LegendOfOwl/hiz-750-rc-jet/cad/out/HIZ750_inboard.pdf

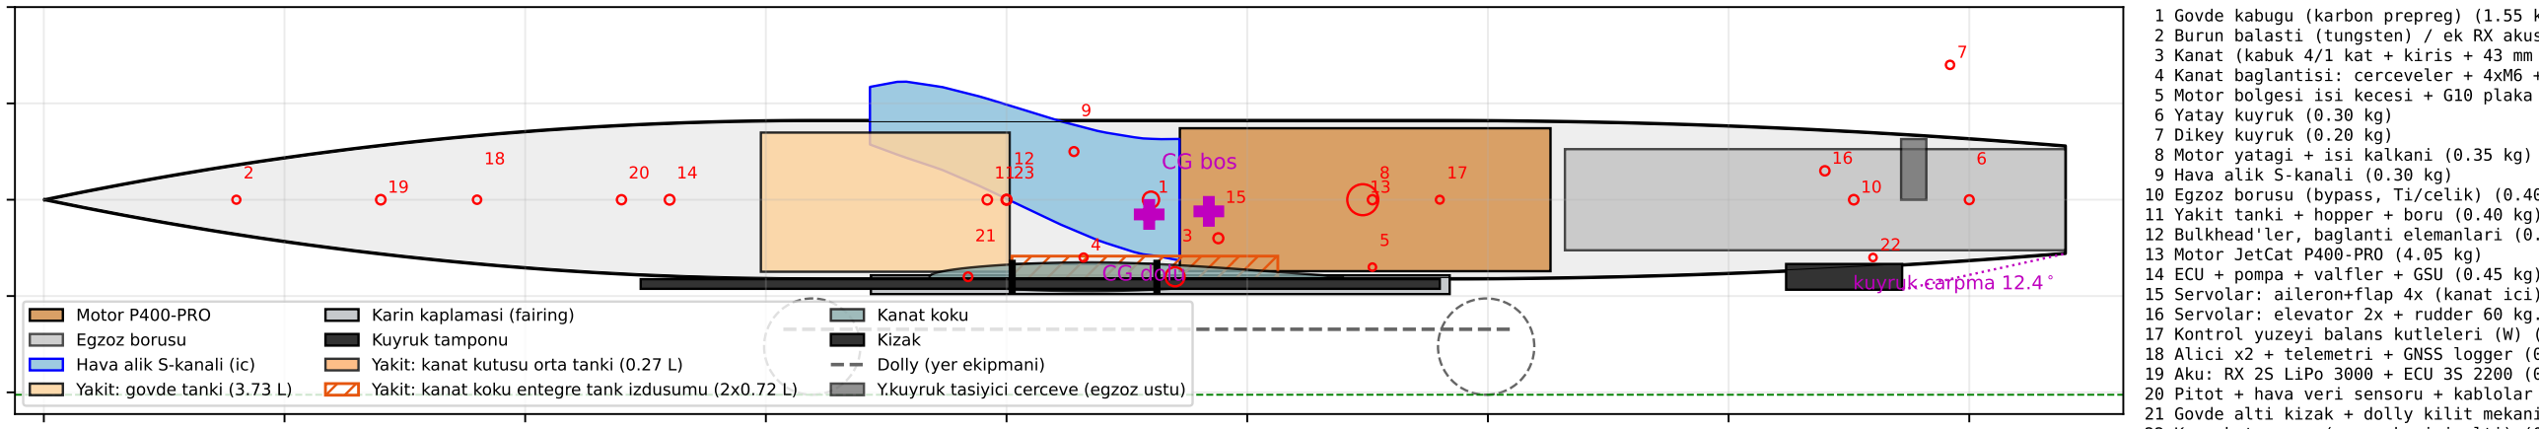
[picture p29: figure]
22 kuyruk carpma 12.4; CG dolu; 6 Yatay kuyruk (0.30 kg) 7 Dikey kuyruk (0.20 kg) 8 Motor yatagi + isi kalkani (0.35 kg) 9 Hava alik S-kanali (0.30 kg); 13 Motor JetCat P400-PRO (4.05 kg)

0 | 250 | 500 | 750 | 1000 | 1250 | 1500 | 1750 | 2000
| | | | x [mm] (burun ucundan)

−200

−100

0

100

200

# z [mm]

2 | 18 19 | 20 14 | 11 | CG bos 12 23 1 15 | 8 17 13 | 16 10 | 6
Motor P400-PRO Egzoz borusu Hava alik S-kanali (ic) Yakit: govde tanki (3.73 L) | Karin kaplamasi (fairing) Kuyruk tamponu Yakit: kanat kutusu orta tanki (0.27 L) Yakit: kanat koku entegre tank izdusumu (2x0.72 L) | | Kanat koku Kizak Dolly (yer ekipmani) Y.kuyruk tasiyici cerceve (egzoz ustu)

1 Govde kabugu (karbon prepreg) (1.55 kg)
2 Burun balasti (tungsten) / ek RX akusu (0.15 kg)
3 Kanat (kabuk 4/1 kat + kiris + 43 mm kaburga) (2.03 kg) 4 Kanat baglantisi: cerceveler + 4xM6 + blok (0.15 kg)
5 Motor bolgesi isi kecesi + G10 plaka (0.05 kg)

10 Egzoz borusu (bypass, Ti/celik) (0.40 kg) 11 Yakit tanki + hopper + boru (0.40 kg)
12 Bulkhead'ler, baglanti elemanlari (0.50 kg)

14 ECU + pompa + valfler + GSU (0.45 kg)
15 Servolar: aileron+flap 4x (kanat ici) (0.48 kg) 16 Servolar: elevator 2x + rudder 60 kg.cm (0.37 kg) 17 Kontrol yuzeyi balans kutleleri (W) (0.12 kg)
18 Alici x2 + telemetri + GNSS logger (0.20 kg)
19 Aku: RX 2S LiPo 3000 + ECU 3S 2200 (0.40 kg)
20 Pitot + hava veri sensoru + kablolar (0.35 kg)
21 Govde alti kizak + dolly kilit mekanizmasi (0.25 kg) 22 Kuyruk tamponu (egzoz konisi alti) (0.04 kg)
23 Boya / dolgu / balans (0.35 kg)

# HIZ-750 ic yerlesim (inboard profile) - merkez duzlem kesiti
