LegendOfOwl/hiz-750-rc-jet/aero/out/ucak_polari_750.png

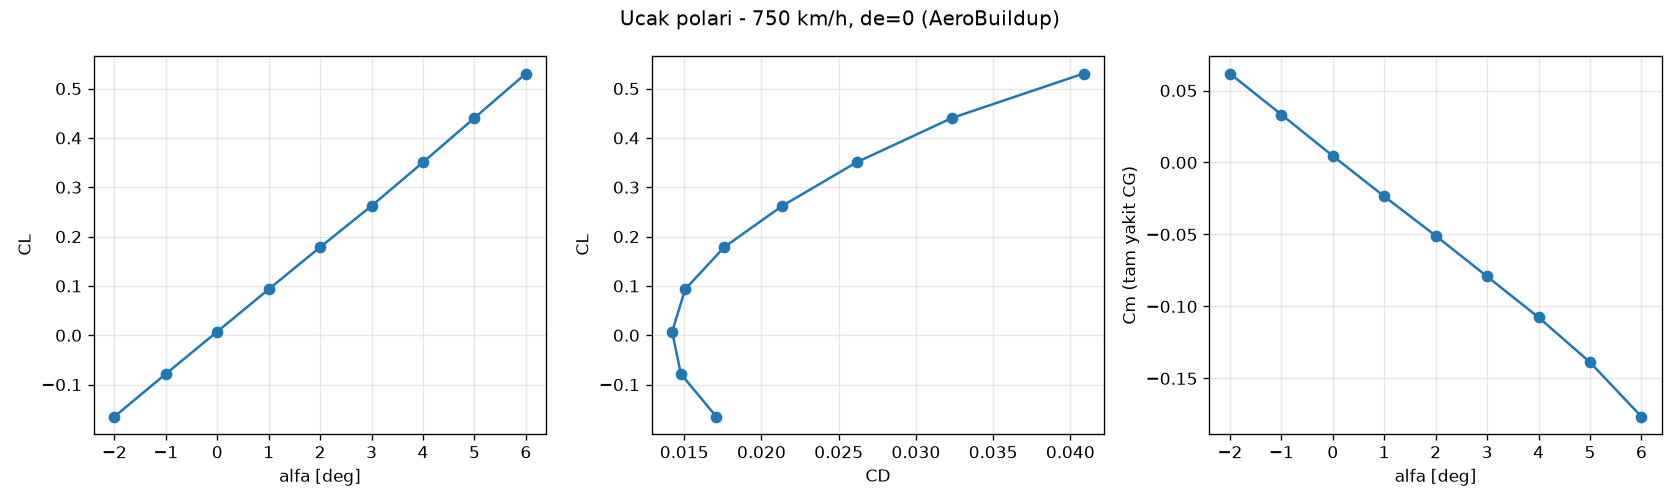
aero/out/ucak_polari_750.png
