LegendOfOwl/hiz-750-rc-jet/out/trade_S_motor.png

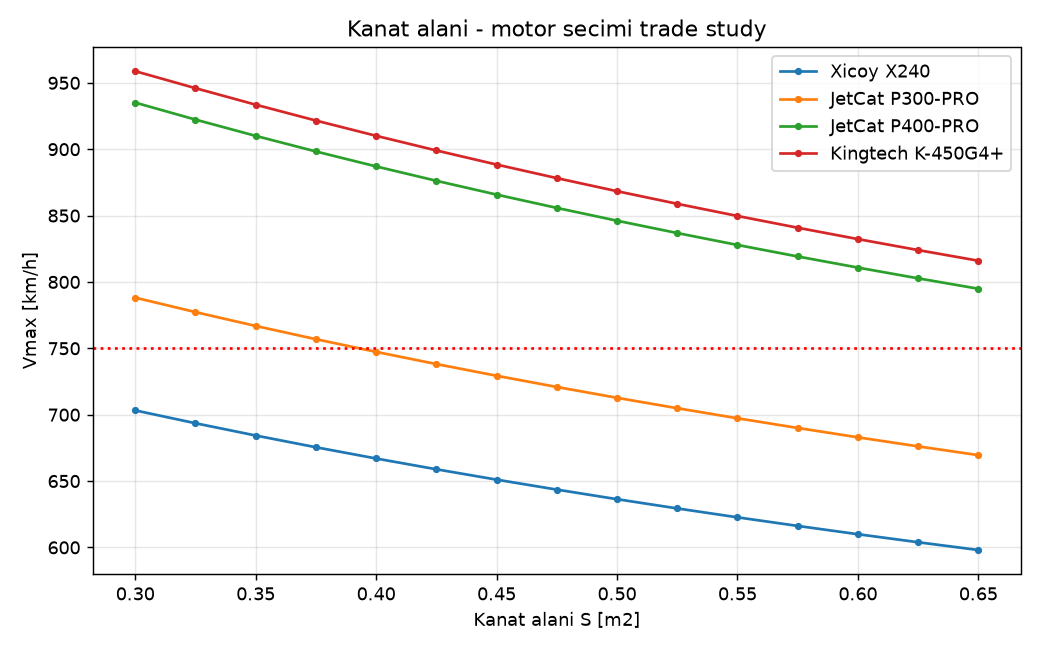
out/trade_S_motor.png
