LegendOfOwl/hiz-750-rc-jet/out/uc_gorunus.png

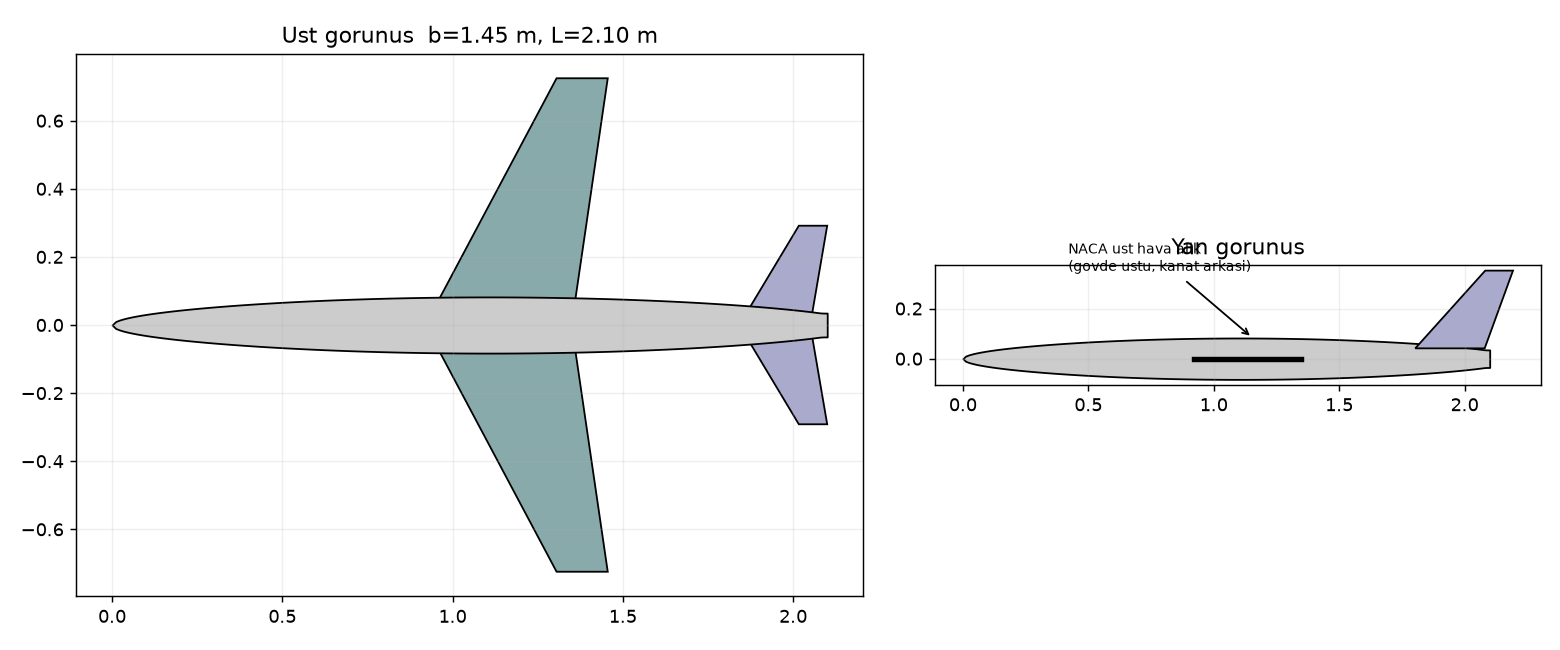
out/uc_gorunus.png
