LegendOfOwl/hiz-750-rc-jet/structures/out_iter1/flutter_GJ_duyarlilik.png

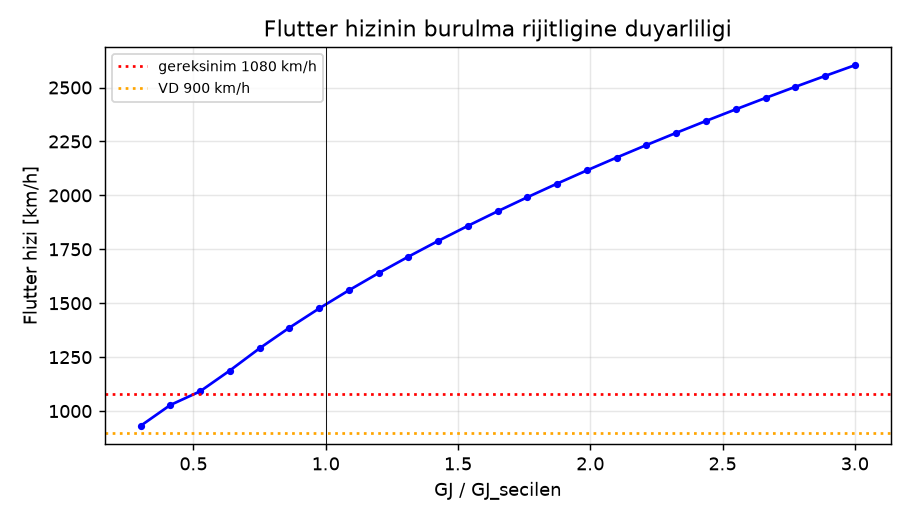
structures/out_iter1/flutter_GJ_duyarlilik.png
