LegendOfOwl/hiz-750-rc-jet/structures/out_iter1/flutter_Vg.png

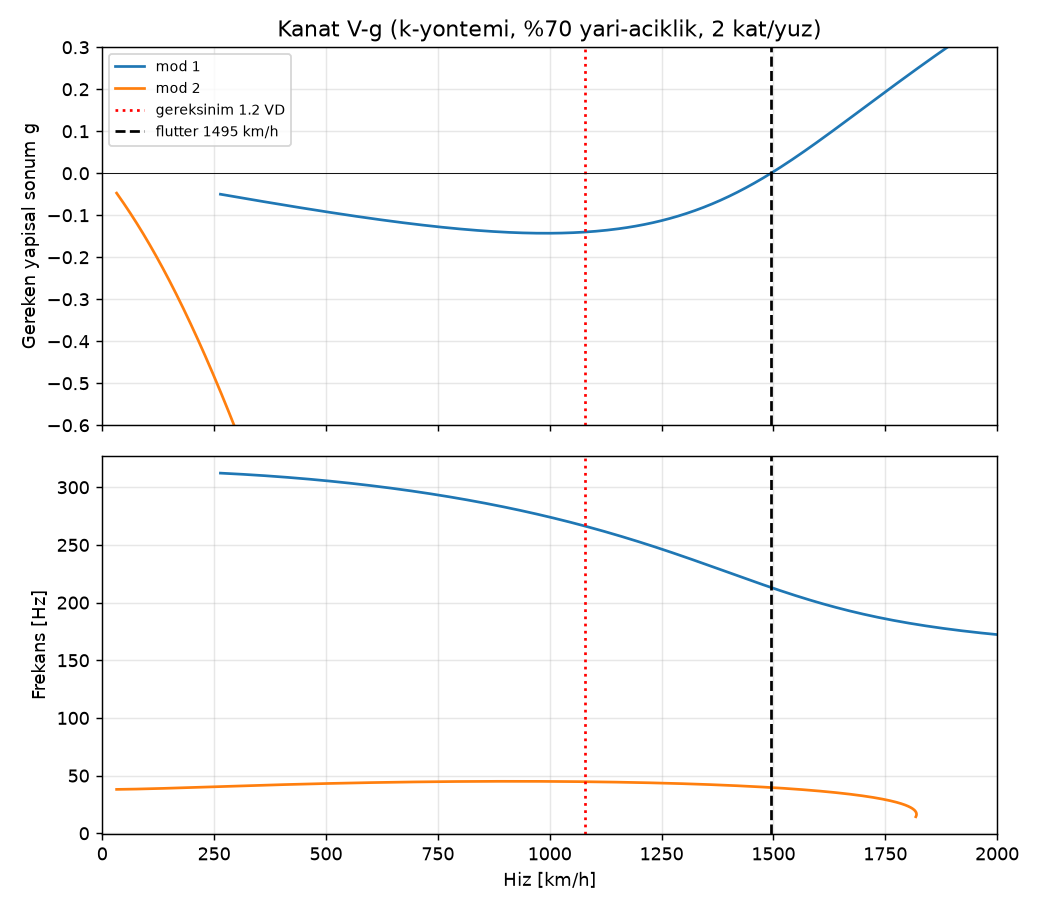
structures/out_iter1/flutter_Vg.png
