LegendOfOwl/hiz-750-rc-jet/structures/out_iter1/kanat_yukleri.png

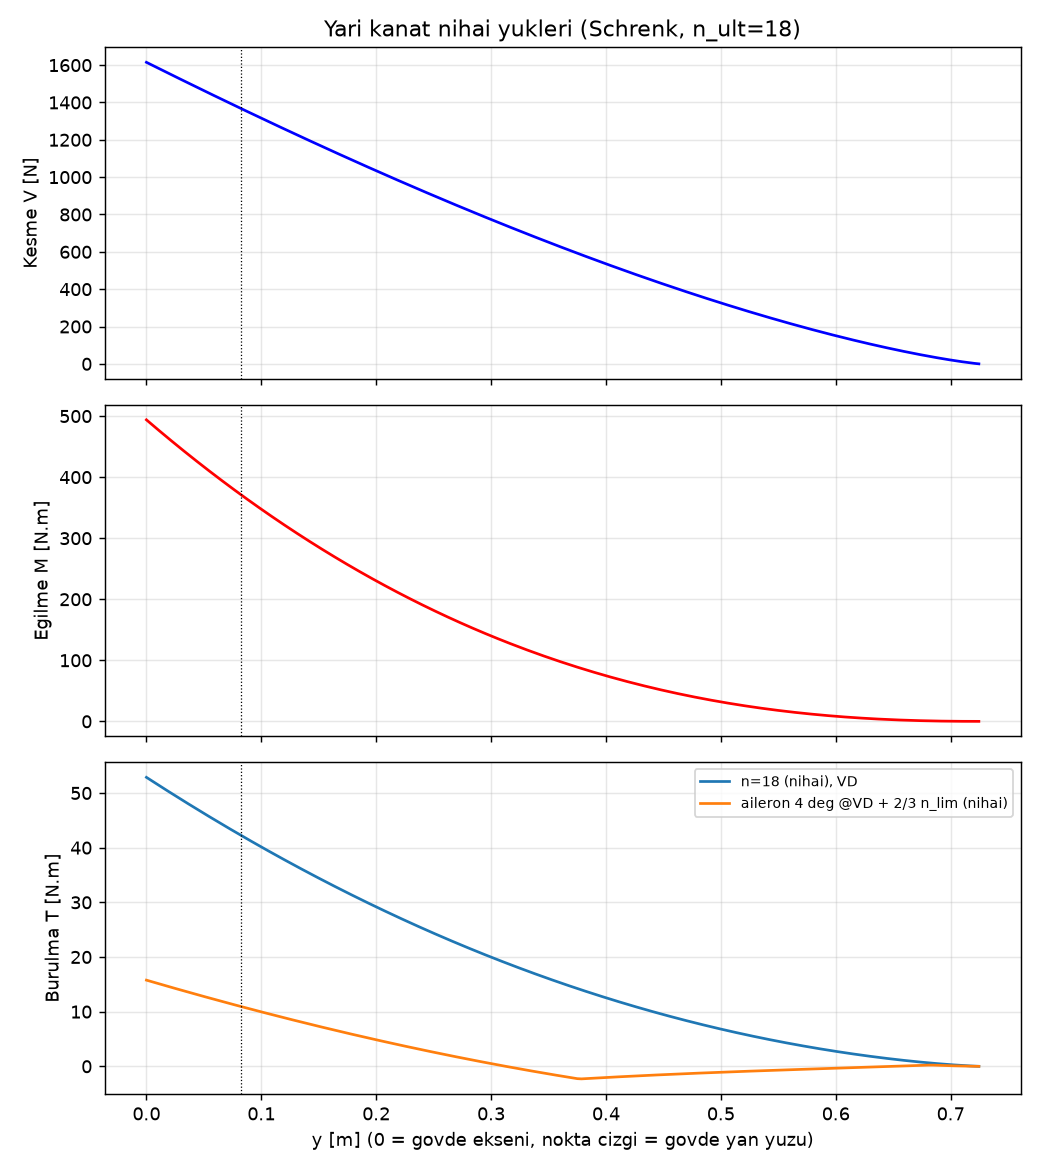
structures/out_iter1/kanat_yukleri.png
