LegendOfOwl/hiz-750-rc-jet/structures/out_iter1/kiris_kat_plani.png

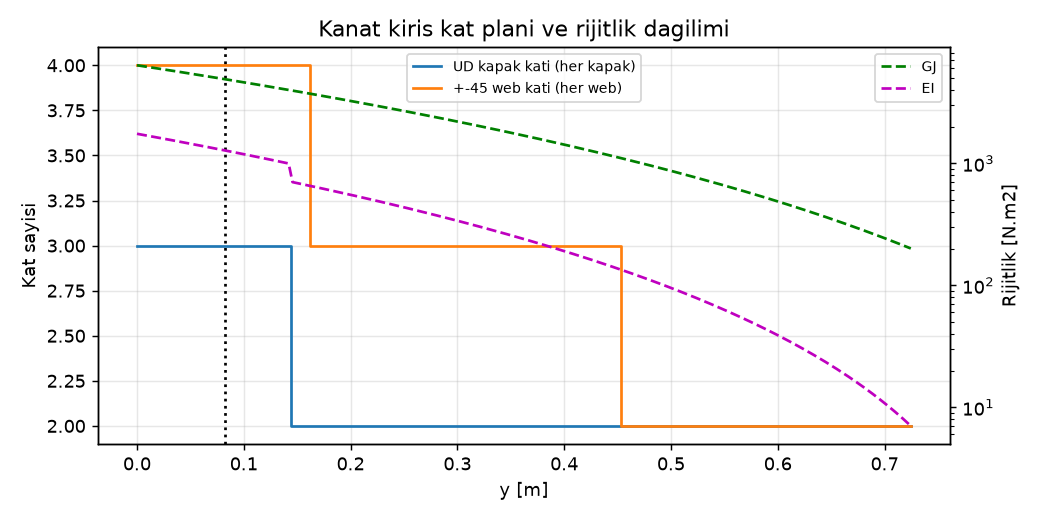
structures/out_iter1/kiris_kat_plani.png
