LegendOfOwl/hiz-750-rc-jet/structures/out_iter1/vn_diyagrami.png

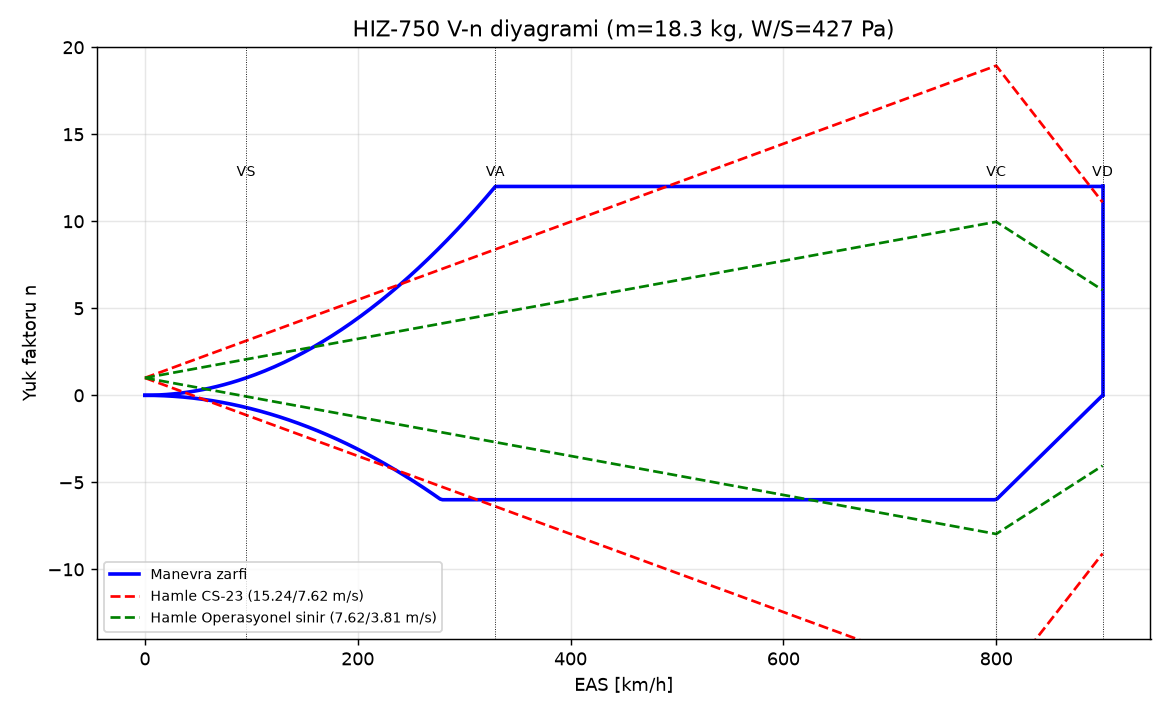
structures/out_iter1/vn_diyagrami.png
