LegendOfOwl/hiz-750-rc-jet/structures/out_iter2/kiris_kat_plani.png

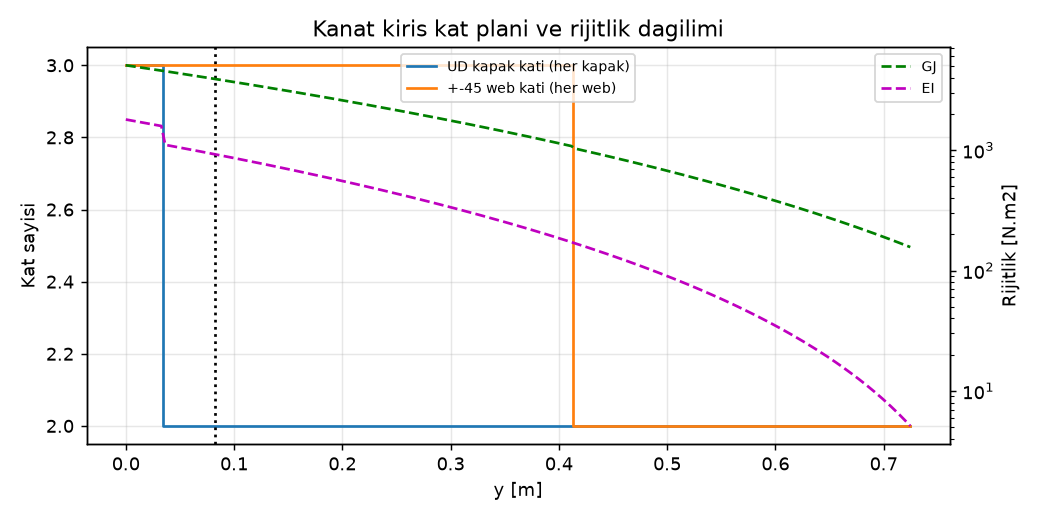
structures/out_iter2/kiris_kat_plani.png
