LegendOfOwl/hiz-750-rc-jet/structures/out_iter2/vn_diyagrami.png

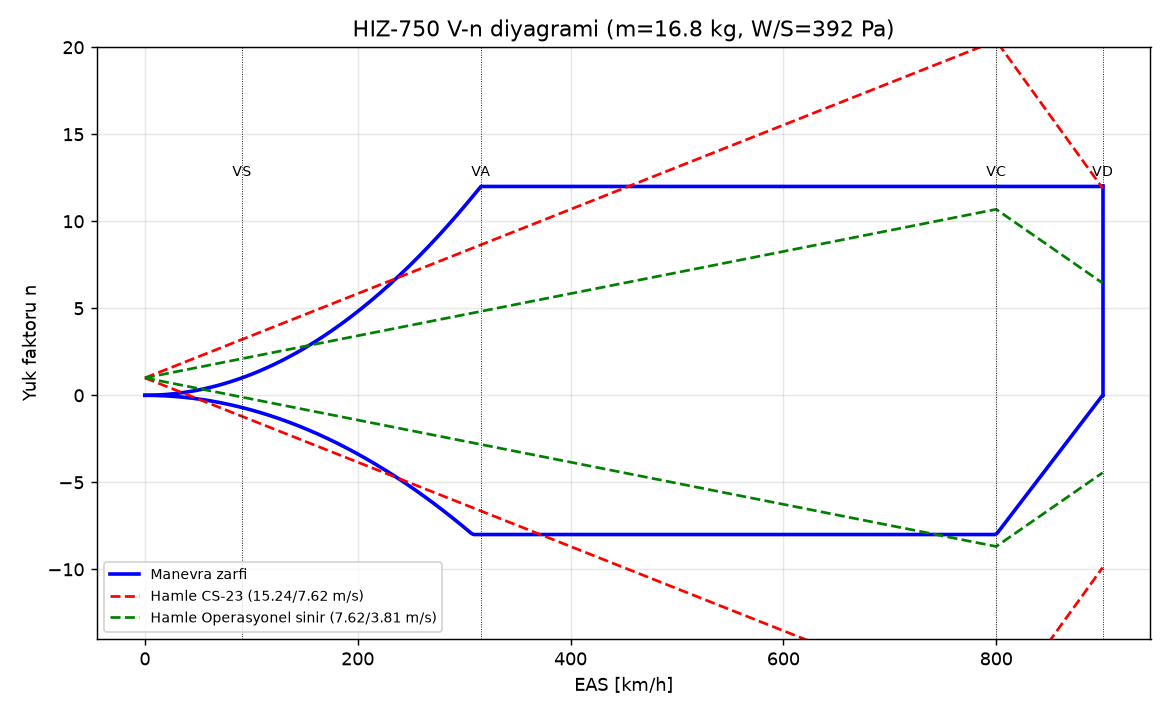
structures/out_iter2/vn_diyagrami.png
