LegendOfOwl/hiz-750-rc-jet/cad/out/step/wing_center.step

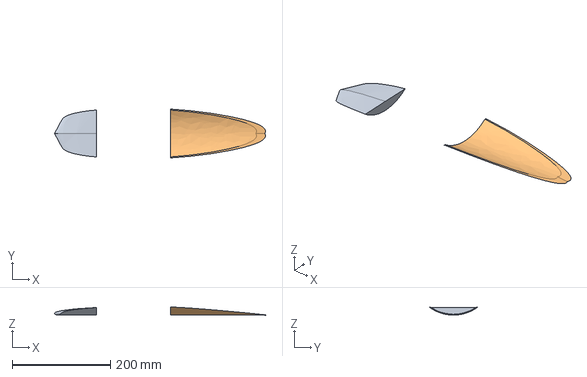
[picture p42: CAD file, 2026-11-08]
cad/out/step/wing_center.step
429.7 x 99.8 x 16.8 mm
