LegendOfOwl/hiz-750-rc-jet/cad/out/step/fuselage.step

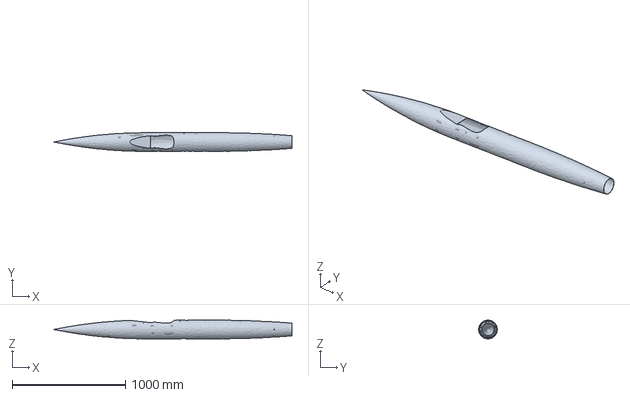
[picture p43: CAD file, 2026-11-08]
cad/out/step/fuselage.step
2100.0 x 165.0 x 165.0 mm
