LegendOfOwl/hiz-750-rc-jet/cad/out/HIZ750_on_dolly.step

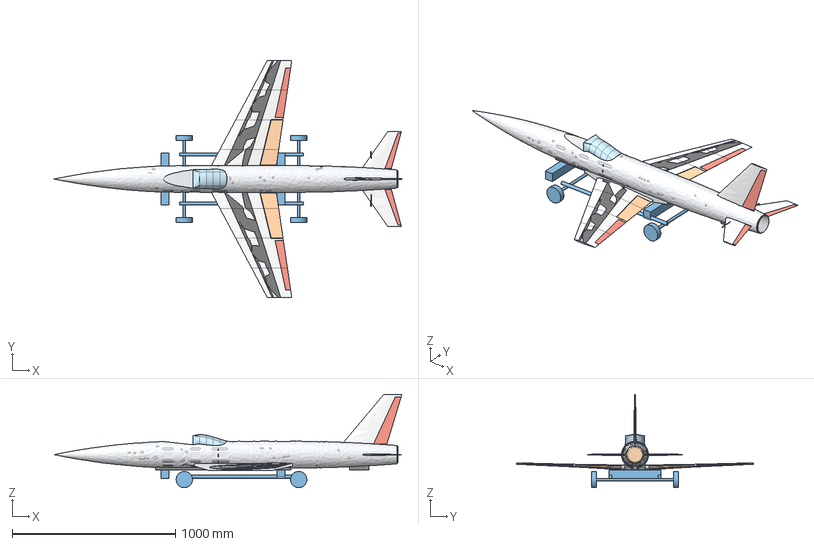
[picture p44: CAD file, 2026-11-08]
cad/out/HIZ750_on_dolly.step
2130.6 x 1449.1 x 572.2 mm
fuselage
inlet_duct
wing_center
aileron_R
flap_R
aileron_L
flap_L
wing_panels
wing_box
belly_fairing
tank_wing_R
tank_wing_L
tank_center
elevator_R
elevator_L
htail
ht_carry_yoke
vtail
rudder
engine
exhaust_pipe
tank_fuselage
skid
tail_bumper
frames
dolly
