LegendOfOwl/hiz-750-rc-jet/cad/out/step/flap_L.step

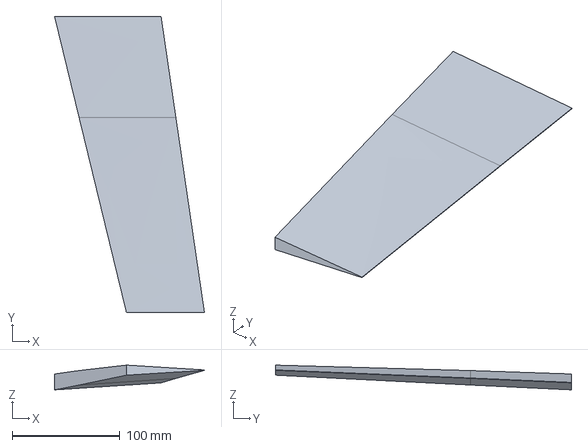
[picture p45: CAD file, 2026-11-08]
cad/out/step/flap_L.step
139.3 x 275.3 x 23.0 mm
