LegendOfOwl/hiz-750-rc-jet/cad/out/step/wing_box.step

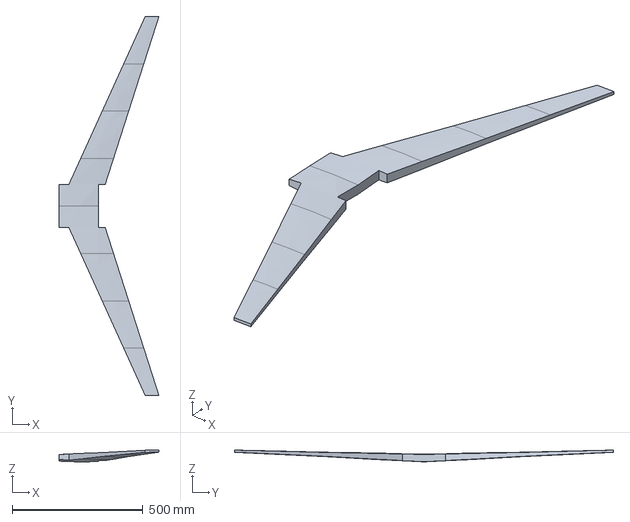
[picture p46: CAD file, 2026-11-08]
cad/out/step/wing_box.step
382.0 x 1449.1 x 45.3 mm
