LegendOfOwl/hiz-750-rc-jet/cad/out/step/tank_center.step

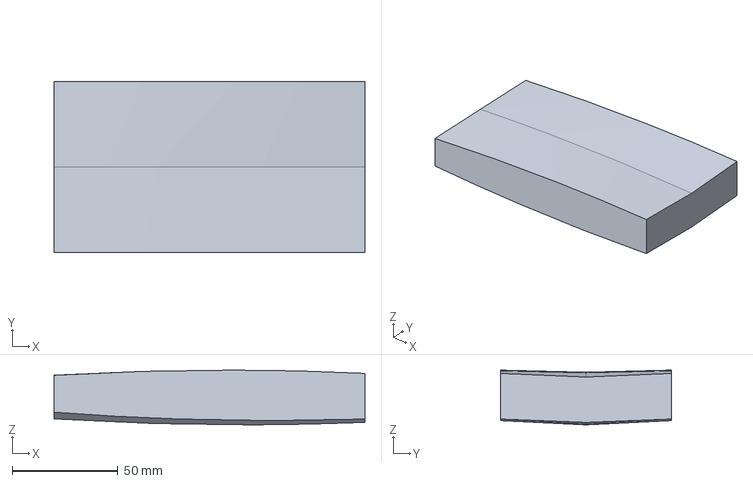
[picture p47: CAD file, 2026-11-08]
cad/out/step/tank_center.step
147.3 x 80.9 x 26.0 mm
