LegendOfOwl/hiz-750-rc-jet/cad/out/step/rudder.step

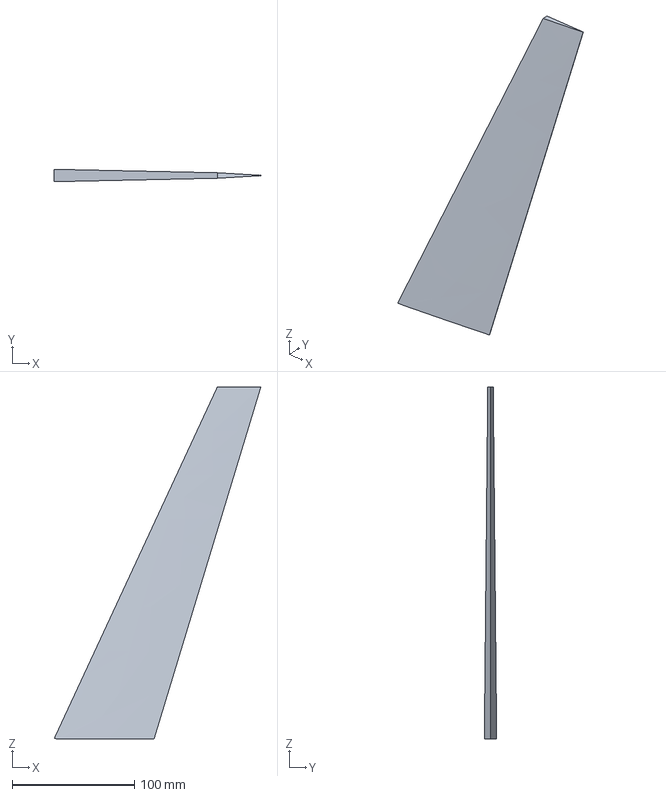
[picture p48: CAD file, 2026-11-08]
cad/out/step/rudder.step
169.4 x 10.1 x 288.4 mm
