LegendOfOwl/hiz-750-rc-jet/cad/out/step/aileron_R.step

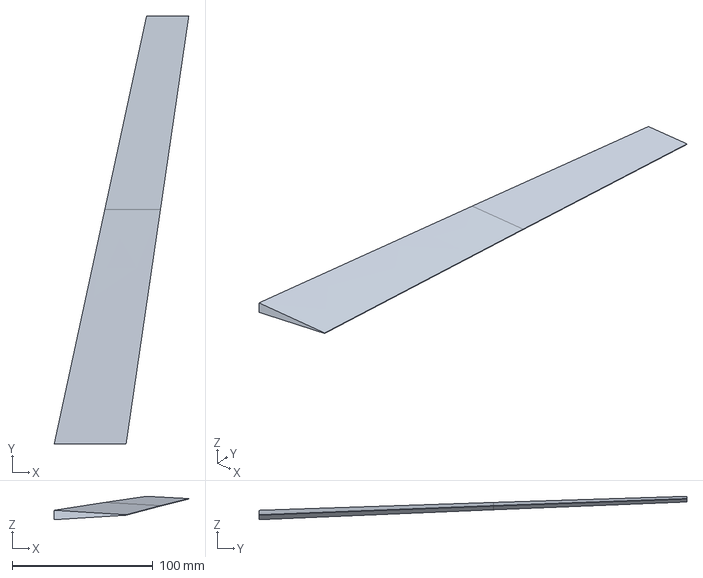
[picture p49: CAD file, 2026-11-08]
cad/out/step/aileron_R.step
95.8 x 304.3 x 16.7 mm
