LegendOfOwl/hiz-750-rc-jet/cad/out/step/elevator_R.step

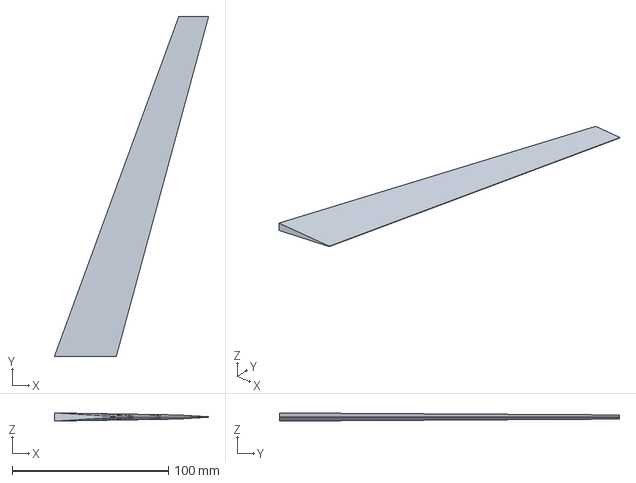
[picture p50: CAD file, 2026-11-08]
cad/out/step/elevator_R.step
98.8 x 217.7 x 5.28 mm
