LegendOfOwl/hiz-750-rc-jet/cad/out/step/engine.step

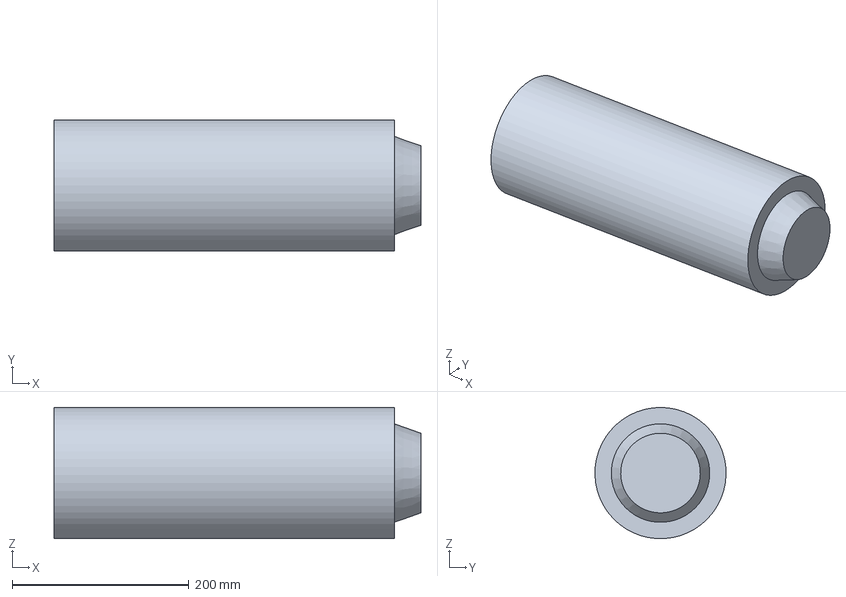
[picture p51: CAD file, 2026-11-08]
cad/out/step/engine.step
415.0 x 148.3 x 148.3 mm
