LegendOfOwl/hiz-750-rc-jet/cad/out/step/skid.step

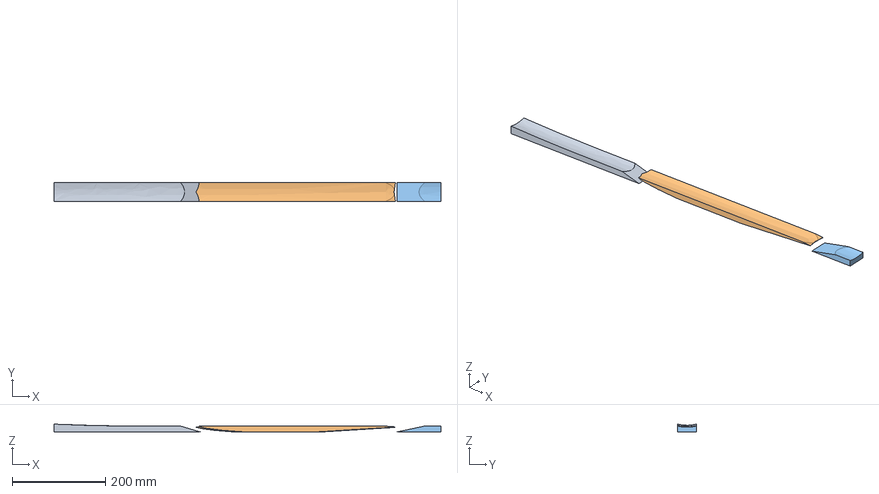
[picture p52: CAD file, 2026-11-08]
cad/out/step/skid.step
830.0 x 40.0 x 16.7 mm
