LegendOfOwl/hiz-750-rc-jet/cad/out/step/ht_carry_yoke.step

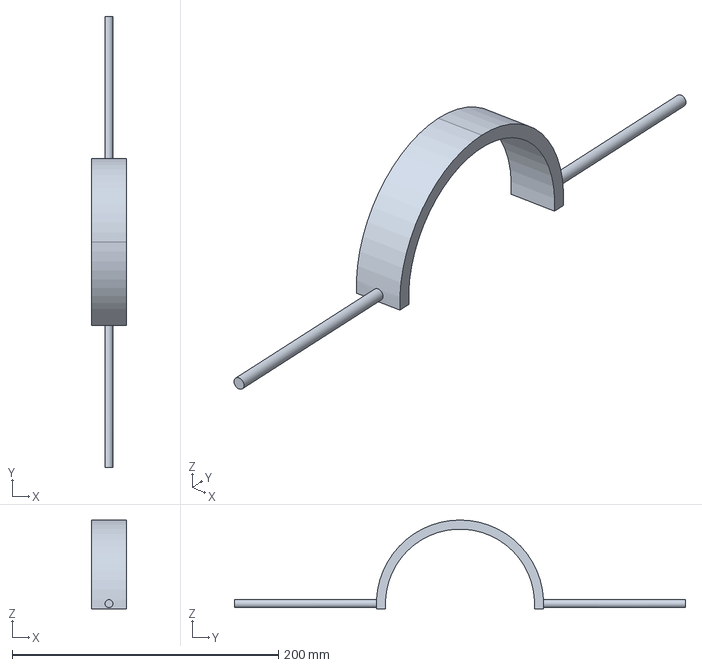
[picture p53: CAD file, 2026-11-08]
cad/out/step/ht_carry_yoke.step
26.0 x 339.0 x 66.9 mm
