LegendOfOwl/hiz-750-rc-jet/cad/out/step/vtail.step

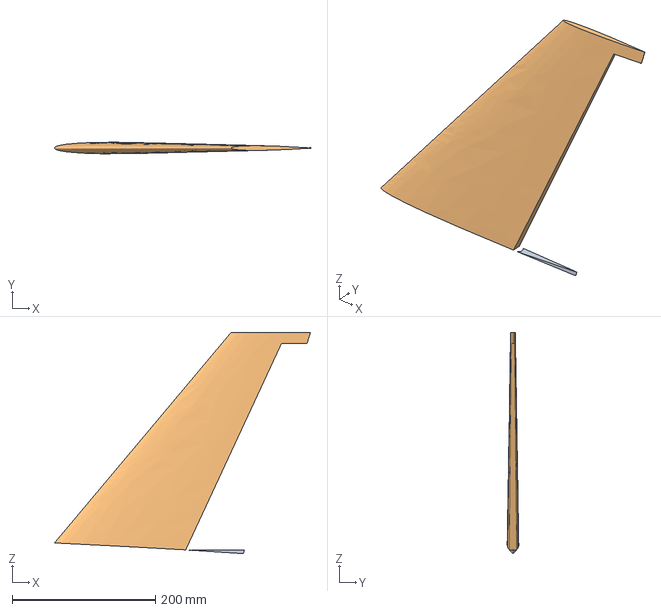
[picture p54: CAD file, 2026-11-08]
cad/out/step/vtail.step
357.3 x 16.2 x 308.9 mm
