LegendOfOwl/hiz-750-rc-jet/cad/out/step/htail.step

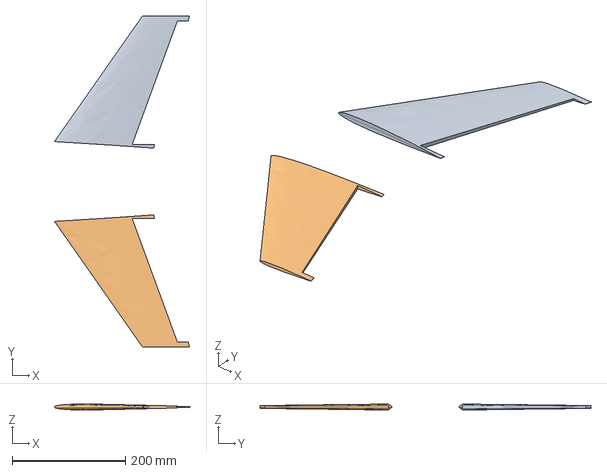
[picture p55: CAD file, 2026-11-08]
cad/out/step/htail.step
238.2 x 583.1 x 10.8 mm
