LegendOfOwl/hiz-750-rc-jet/cad/out/step/inlet_duct.step

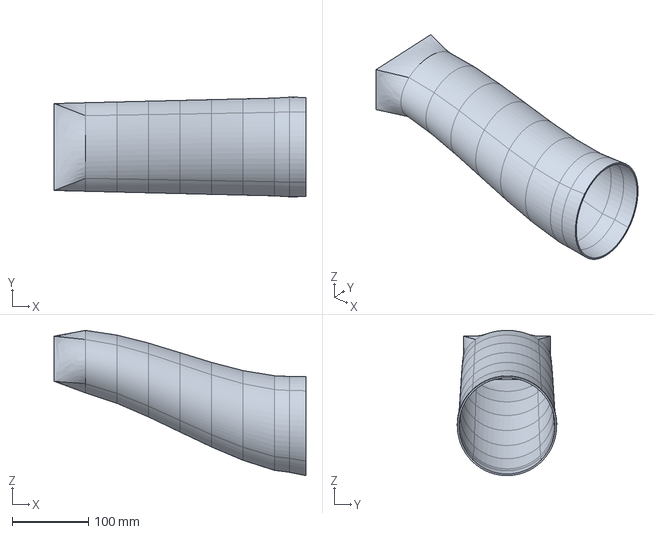
[picture p56: CAD file, 2026-11-08]
cad/out/step/inlet_duct.step
330.0 x 130.5 x 190.2 mm
