LegendOfOwl/hiz-750-rc-jet/cad/out/step/frames.step

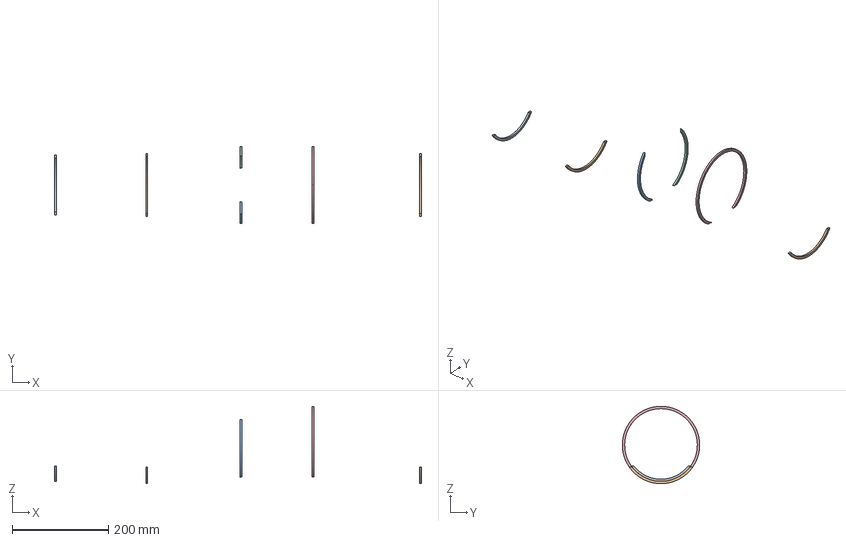
[picture p57: CAD file, 2026-11-08]
cad/out/step/frames.step
764.0 x 161.2 x 161.2 mm
