LegendOfOwl/hiz-750-rc-jet/cad/out/step/tail_bumper.step

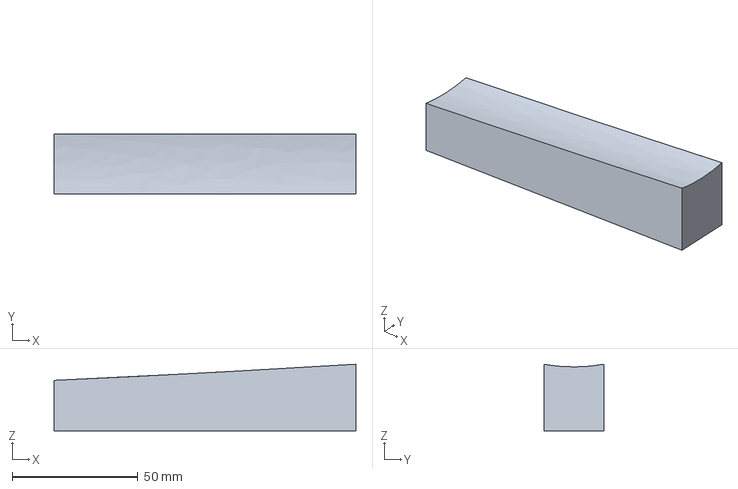
[picture p58: CAD file, 2026-11-08]
cad/out/step/tail_bumper.step
120.0 x 24.0 x 26.5 mm
