LegendOfOwl/hiz-750-rc-jet/cad/out/step/wing_panels.step

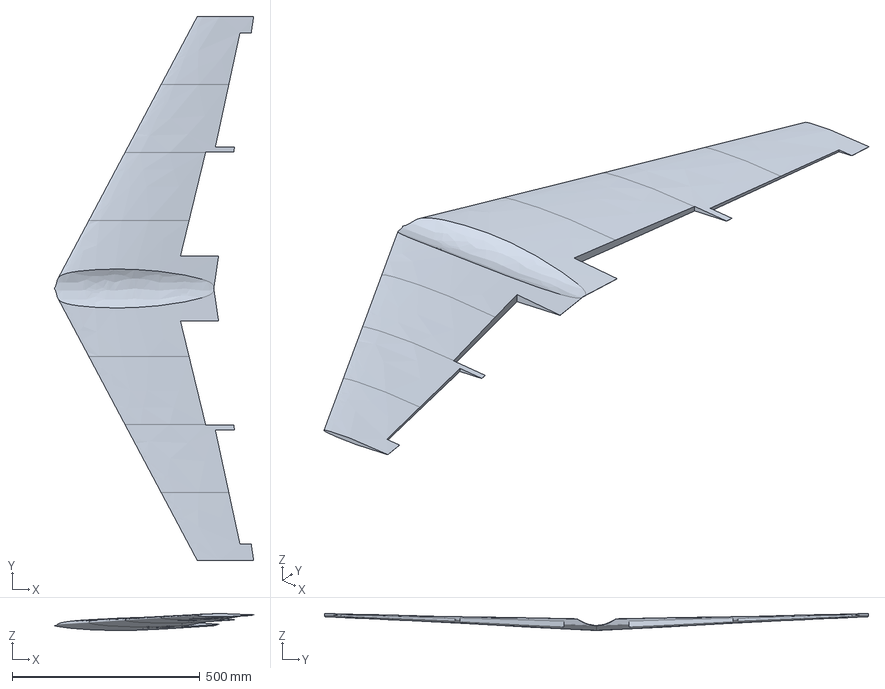
[picture p59: CAD file, 2026-11-08]
cad/out/step/wing_panels.step
531.1 x 1449.1 x 45.6 mm
