LegendOfOwl/hiz-750-rc-jet/cad/out/step/belly_fairing.step

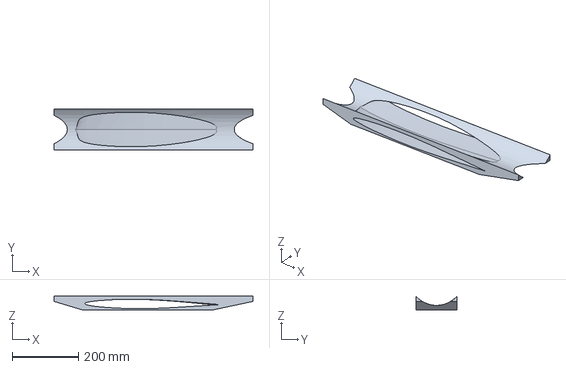
[picture p60: CAD file, 2026-11-08]
cad/out/step/belly_fairing.step
599.4 x 123.8 x 41.5 mm
