LegendOfOwl/hiz-750-rc-jet/cad/out/step/exhaust_pipe.step

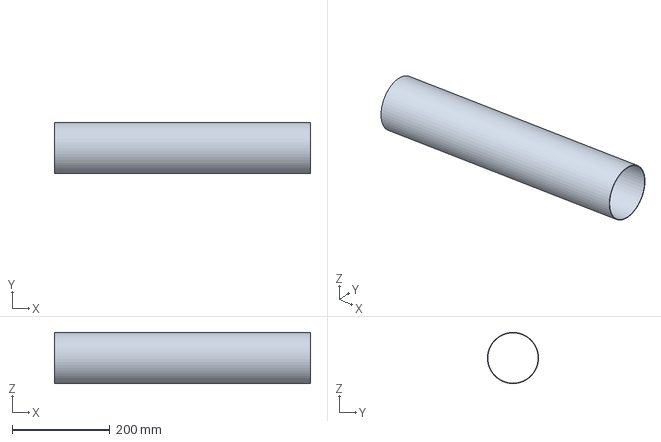
[picture p61: CAD file, 2026-11-08]
cad/out/step/exhaust_pipe.step
525.0 x 105.0 x 104.9 mm
