LegendOfOwl/hiz-750-rc-jet/cad/out/step/tank_wing_R.step

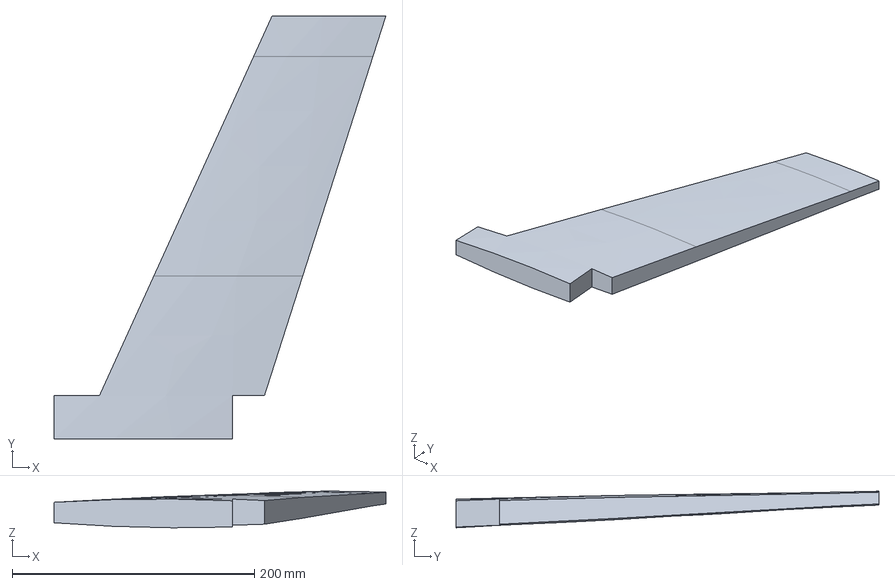
[picture p62: CAD file, 2026-11-08]
cad/out/step/tank_wing_R.step
273.8 x 349.0 x 30.2 mm
