LegendOfOwl/hiz-750-rc-jet/cad/out/step/tank_fuselage.step

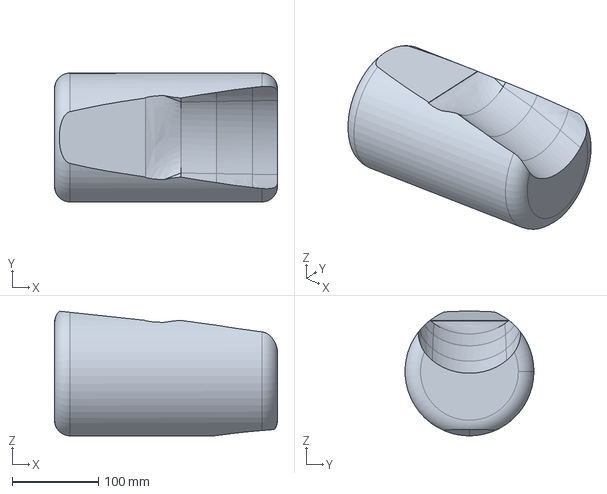
[picture p63: CAD file, 2026-11-08]
cad/out/step/tank_fuselage.step
258.0 x 149.1 x 144.3 mm
