LegendOfOwl/hiz-750-rc-jet/cad/out/step/dolly.step

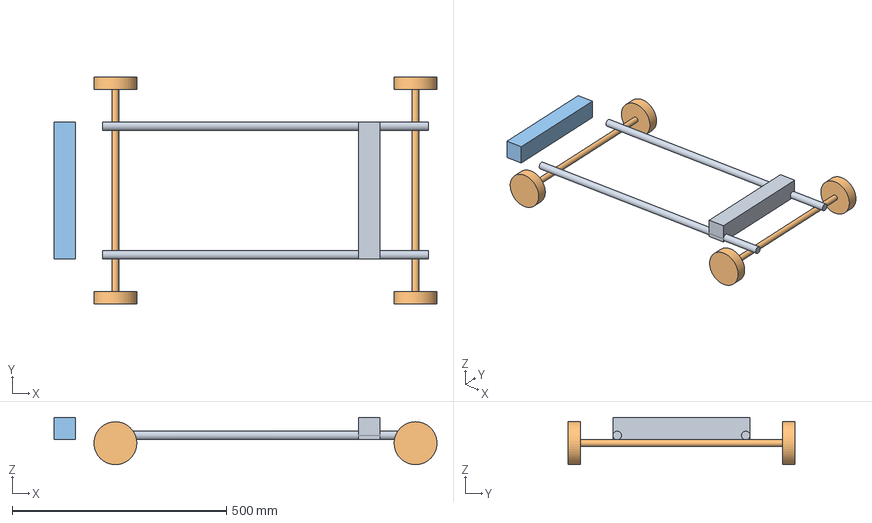
[picture p64: CAD file, 2026-11-08]
cad/out/step/dolly.step
893.1 x 530.0 x 109.9 mm
