LegendOfOwl/hiz-750-rc-jet/(list of files, cad)

Other CAD files:
cad/out/HIZ750_3view.dxf
cad/out/step/aileron_L.step
cad/out/step/flap_R.step
cad/out/step/tank_wing_L.step
cad/out/step/elevator_L.step
cad/out/stl/aileron_L.stl
cad/out/stl/aileron_R.stl
cad/out/stl/belly_fairing.stl
cad/out/stl/dolly.stl
cad/out/stl/elevator_L.stl
cad/out/stl/elevator_R.stl
cad/out/stl/engine.stl
cad/out/stl/exhaust_pipe.stl
cad/out/stl/flap_L.stl
cad/out/stl/flap_R.stl
cad/out/stl/frames.stl
cad/out/stl/fuselage.stl
cad/out/stl/ht_carry_yoke.stl
cad/out/stl/htail.stl
cad/out/stl/inlet_duct.stl
cad/out/stl/rudder.stl
cad/out/stl/skid.stl
cad/out/stl/tail_bumper.stl
cad/out/stl/tank_center.stl
cad/out/stl/tank_fuselage.stl
cad/out/stl/tank_wing_L.stl
cad/out/stl/tank_wing_R.stl
cad/out/stl/vtail.stl
cad/out/stl/wing_box.stl
cad/out/stl/wing_center.stl
cad/out/stl/wing_panels.stl
