LegendOfOwl/hiz-750-rc-jet/performance/out/kutle_tablosu.md

| Kalem | Kutle [kg] | x [m] | z [m] | Moment [kg.m] |
|---|---:|---:|---:|---:|
| Govde kabugu (karbon prepreg) | 1.55 | 1.150 | 0.000 | 1.782 |
| Burun balasti (tungsten) / ek RX akusu | 0.15 | 0.200 | 0.000 | 0.030 |
| Kanat (kabuk 4/1 kat + kiris + 43 mm kaburga) | 2.03 | 1.175 | -0.080 | 2.385 |
| Kanat baglantisi: cerceveler + 4xM6 + blok | 0.15 | 1.080 | -0.060 | 0.162 |
| Motor bolgesi isi kecesi + G10 plaka | 0.05 | 1.380 | -0.070 | 0.069 |
| Yatay kuyruk | 0.30 | 2.000 | 0.000 | 0.600 |
| Dikey kuyruk | 0.20 | 1.980 | 0.140 | 0.396 |
| Motor yatagi + isi kalkani | 0.35 | 1.380 | 0.000 | 0.483 |
| Hava alik S-kanali | 0.30 | 1.070 | 0.050 | 0.321 |
| Egzoz borusu (bypass, Ti/celik) | 0.40 | 1.880 | 0.000 | 0.752 |
| Yakit tanki + hopper + boru | 0.40 | 0.980 | 0.000 | 0.392 |
| Bulkhead'ler, baglanti elemanlari | 0.50 | 1.000 | 0.000 | 0.500 |
| Motor JetCat P400-PRO | 4.05 | 1.370 | 0.000 | 5.548 |
| ECU + pompa + valfler + GSU | 0.45 | 0.650 | 0.000 | 0.293 |
| Servolar: aileron+flap 4x (kanat ici) | 0.48 | 1.220 | -0.040 | 0.586 |
| Servolar: elevator 2x + rudder 60 kg.cm | 0.37 | 1.850 | 0.030 | 0.684 |
| Kontrol yuzeyi balans kutleleri (W) | 0.12 | 1.450 | 0.000 | 0.174 |
| Alici x2 + telemetri + GNSS logger | 0.20 | 0.450 | 0.000 | 0.090 |
| Aku: RX 2S LiPo 3000 + ECU 3S 2200 | 0.40 | 0.350 | 0.000 | 0.140 |
| Pitot + hava veri sensoru + kablolar | 0.35 | 0.600 | 0.000 | 0.210 |
| Govde alti kizak + dolly kilit mekanizmasi | 0.25 | 0.960 | -0.080 | 0.240 |
| Kuyruk tamponu (egzoz konisi alti) | 0.04 | 1.900 | -0.060 | 0.076 |
| Boya / dolgu / balans | 0.35 | 1.000 | 0.000 | 0.350 |
| Yakit (5.0 L) | 4.00 | 0.940 | -0.026 | 3.760 |
| **MTOW** | **17.44** | **1.148** | -0.015 | |

MAC = 0.312 m, MAC hucum kenari x = 1.082 m.  CG tam yakit %21.3 MAC, yakitsiz %41.1 MAC.
