LegendOfOwl/hiz-750-rc-jet/validation/results/thermal_1d/study.md

# thermal_1d: BENCHMARK_ACCEPTED

| Büyüklük | Kaba / orta / ince | p | GCI ince [%] | Referans hata kaba / orta / ince [%] |
|---|---|---|---|---|
| outer_K | 357.15 / 357.15 / 357.15 | EXACT_OR_ROUNDOFF | — | 0.0 / 0.0 / 0.0 |
| heat_flux_W_m2 | 1600 / 1600 / 1600 | EXACT_OR_ROUNDOFF | — | 0.0 / 0.0 / 0.0 |
