LegendOfOwl/hiz-750-rc-jet/fem/results/stiffening/wing_empty_s31/study.md

# wing_empty_s31: PENDING

| Büyüklük | Kaba / orta / ince | p | GCI ince [%] | Referans hata kaba / orta / ince [%] |
|---|---|---|---|---|
| Tüm değerler | bekliyor | — | — | — |

Üç ağ sonucu bekleniyor
