LegendOfOwl/hiz-750-rc-jet/validation/results/flat_plate_SA/study.md

# flat_plate_SA: BENCHMARK_ACCEPTED

| Büyüklük | Kaba / orta / ince | p | GCI ince [%] | Referans hata kaba / orta / ince [%] |
|---|---|---|---|---|
| cl | -0.18828755 / -0.18828757 / -0.18828702 | OSCILLATORY | — | bekliyor / bekliyor / bekliyor |
| cd | 0.0028542517 / 0.0028586462 / 0.0028613266 | 0.4344615788916978 | 1.8166063665108316 | bekliyor / bekliyor / bekliyor |
| cm | -0.18781801 / -0.18781445 / -0.18781152 | NO_OBSERVED_ORDER | — | bekliyor / bekliyor / bekliyor |
| cf_mean | 0.0028542517 / 0.0028586462 / 0.0028613266 | 0.4344615788916978 | 1.8166063665108316 | -4.975888738145098 / -4.8295858811416235 / -4.740349821598857 |
| cf_ittc | 0.003 / 0.003 / 0.003 | EXACT_OR_ROUNDOFF | — | bekliyor / bekliyor / bekliyor |
| cf_schlichting | 0.0030037131 / 0.0030037131 / 0.0030037131 | EXACT_OR_ROUNDOFF | — | bekliyor / bekliyor / bekliyor |
