LegendOfOwl/hiz-750-rc-jet/validation/results/rae2822_SA/study.md

# rae2822_SA: PENDING

| Büyüklük | Kaba / orta / ince | p | GCI ince [%] | Referans hata kaba / orta / ince [%] |
|---|---|---|---|---|
| Tüm değerler | bekliyor | — | — | — |

Üç ağın da yakınsamış COMPUTED sonucu gerekli
