LegendOfOwl/hiz-750-rc-jet/validation/results/cantilever/study.md

# cantilever: BENCHMARK_ACCEPTED

| Büyüklük | Kaba / orta / ince | p | GCI ince [%] | Referans hata kaba / orta / ince [%] |
|---|---|---|---|---|
| tip_deflection_m | 0.0003734951 / 0.0003768355 / 0.0003781402 | 1.3563027555676133 | 0.276416976057077 | -1.9575362499999938 / -1.080681249999985 / -0.7381974999999827 |
| f1_Hz | 8.492973 / 8.442452 / 8.422987 | 1.3760008510665807 | 0.1810536067058048 | 1.3251222573879553 / 0.7223832045774167 / 0.49015669158366454 |
| f2_Hz | 41.91958 / 41.86517 / 41.85491 | 2.406841097452576 | 0.007120780754258444 | bekliyor / bekliyor / bekliyor |
| f3_Hz | 53.22299 / 52.88753 / 52.76328 | 1.4328948990134691 | 0.17316357600906793 | bekliyor / bekliyor / bekliyor |
| f4_Hz | 149.1271 / 148.0265 / 147.666 | 1.6102190692011873 | 0.14864477094331294 | bekliyor / bekliyor / bekliyor |
| f5_Hz | 259.7974 / 259.389 / 259.3141 | 2.4469452424186864 | 0.00810870831474893 | bekliyor / bekliyor / bekliyor |
