LegendOfOwl/hiz-750-rc-jet/validation/results/coupon/study.md

# coupon: BENCHMARK_ACCEPTED

| Büyüklük | Kaba / orta / ince | p | GCI ince [%] | Referans hata kaba / orta / ince [%] |
|---|---|---|---|---|
| UD0_Ex | 1.25e+11 / 1.25e+11 / 1.25e+11 | EXACT_OR_ROUNDOFF | — | 0.0 / 0.0 / 4.882812500000001e-14 |
| UD0_Ey | 8.9999977e+09 / 8.9999977e+09 / 8.9999977e+09 | EXACT_OR_ROUNDOFF | — | -2.5999993218315972e-05 / -2.5999993218315972e-05 / -2.5999993218315972e-05 |
| UD0_Gxy | 5e+09 / 5e+09 / 5e+09 | EXACT_OR_ROUNDOFF | — | 9.7686767578125e-10 / -4.4330596923828125e-10 / 9.765625e-12 |
| UD0_D11beam | 10.416662 / 10.416668 / 10.416667 | OSCILLATORY | — | -4.938269175340793e-05 / 1.6460908096860293e-05 / 5.1159076974727215e-14 |
| UD0_wB3 | 0.0054014182 / 0.0054014192 / 0.0054014193 | 3.5849625019724947 | 1.7531868046999295e-07 | -0.0070686314438442935 / -0.007050119096102041 / -0.007048576400458191 |
| UD0_TX_L1_s11 | 1000000 / 1000000 / 1000000 | EXACT_OR_ROUNDOFF | — | 0.0 / 0.0 / 0.0 |
| UD0_TX_L2_s11 | 1000000 / 1000000 / 1000000 | EXACT_OR_ROUNDOFF | — | 0.0 / 0.0 / 0.0 |
| UD0_TX_L3_s11 | 1000000 / 1000000 / 1000000 | EXACT_OR_ROUNDOFF | — | 0.0 / 0.0 / 0.0 |
| UD0_TX_L4_s11 | 1000000 / 1000000 / 1000000 | EXACT_OR_ROUNDOFF | — | 0.0 / 0.0 / 0.0 |
| UD0_TX_L5_s11 | 1000000 / 1000000 / 1000000 | EXACT_OR_ROUNDOFF | — | 0.0 / 0.0 / 0.0 |
| UD45S_Ex | 1.750487e+10 / 1.7504731e+10 / 1.7504726e+10 | 4.722902292336094 | 1.4783634641051722e-06 | 0.000275781654758961 / -0.0005177683550961395 / -0.0005478179792751142 |
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
| WEB_wB3 | 0.28371987 / 0.28373875 / 0.28374 | 3.911357147468949 | 3.9334734156698135e-05 | -0.2934517657731332 / -0.2868200638030725 / -0.286379316995225 |
| WEB_TX_L1_s12 | -936329.6 / -936329.6 / -936329.6 | EXACT_OR_ROUNDOFF | — | -1.2800000255461779e-06 / -1.2799997520167376e-06 / -1.280000833701342e-06 |
