LegendOfOwl/hiz-750-rc-jet/thermal/results/engine_thermal_T250_F0_1ed7ca8299/study.md

# engine_thermal_T250_F0_1ed7ca8299: REVIEW_REQUIRED

| Büyüklük | Kaba / orta / ince | p | GCI ince [%] | Referans hata kaba / orta / ince [%] |
|---|---|---|---|---|
| outer_K | 322.6096 / 322.6096 / 322.6096 | EXACT_OR_ROUNDOFF | — | 2.5957443262691604e-06 / 2.5957443262691604e-06 / 2.5957443262691604e-06 |
| heat_flux_W_m2 | 3102.3198 / 3102.3198 / 3102.3198 | EXACT_OR_ROUNDOFF | — | 2.8637646226195755e-05 / 2.8637646226195755e-05 / 2.8637646226195755e-05 |
| inner_K | 331.9165 / 331.9165 / 331.9165 | EXACT_OR_ROUNDOFF | — | -1.4561221487323828e-05 / -1.4561221487323828e-05 / -1.4561221487323828e-05 |
| shell_inner_K | 331.9165 / 331.9165 / 331.9165 | EXACT_OR_ROUNDOFF | — | -1.4561221487323828e-05 / -1.4561221487323828e-05 / -1.4561221487323828e-05 |
| shell_inner_C | 58.7665 / 58.7665 / 58.7665 | EXACT_OR_ROUNDOFF | — | bekliyor / bekliyor / bekliyor |
