LegendOfOwl/hiz-750-rc-jet/thermal/results/engine_thermal_T250_F0_803b2f042b/study.md

# engine_thermal_T250_F0_803b2f042b: REVIEW_REQUIRED

| Büyüklük | Kaba / orta / ince | p | GCI ince [%] | Referans hata kaba / orta / ince [%] |
|---|---|---|---|---|
| outer_K | 324.8414 / 324.8414 / 324.8414 | EXACT_OR_ROUNDOFF | — | 5.3977383837816395e-06 / 5.3977383837816395e-06 / 5.3977383837816395e-06 |
| heat_flux_W_m2 | 3339.2387 / 3339.2387 / 3339.2387 | EXACT_OR_ROUNDOFF | — | 5.5775233796347544e-05 / 5.5775233796347544e-05 / 5.5775233796347544e-05 |
| inner_K | 334.8591 / 334.8591 / 334.8591 | EXACT_OR_ROUNDOFF | — | 2.0796641595317134e-06 / 2.0796641595317134e-06 / 2.0796641595317134e-06 |
| shell_inner_K | 334.8591 / 334.8591 / 334.8591 | EXACT_OR_ROUNDOFF | — | 2.0796641595317134e-06 / 2.0796641595317134e-06 / 2.0796641595317134e-06 |
| shell_inner_C | 61.7091 / 61.7091 / 61.7091 | EXACT_OR_ROUNDOFF | — | bekliyor / bekliyor / bekliyor |
