LegendOfOwl/hiz-750-rc-jet/thermal/results/engine_thermal_T250_F2_679b6a3875/study.md

# engine_thermal_T250_F2_679b6a3875: REVIEW_REQUIRED

| Büyüklük | Kaba / orta / ince | p | GCI ince [%] | Referans hata kaba / orta / ince [%] |
|---|---|---|---|---|
| outer_K | 393.9534 / 393.9534 / 393.9534 | EXACT_OR_ROUNDOFF | — | 3.565757147749139e-06 / 3.565757147749139e-06 / 3.565757147749139e-06 |
| heat_flux_W_m2 | 1765.6714 / 1765.6714 / 1765.6714 | EXACT_OR_ROUNDOFF | — | 1.678224195887359e-05 / 1.678224195887359e-05 / 1.678224195887359e-05 |
| inner_K | 458.1061 / 458.1061 / 458.1061 | EXACT_OR_ROUNDOFF | — | -8.22156186888192e-07 / -8.22156186888192e-07 / -8.22156186888192e-07 |
| shell_inner_K | 399.2504 / 399.2504 / 399.2504 | EXACT_OR_ROUNDOFF | — | 1.6279353714992333e-07 / 1.6279353714992333e-07 / 1.6279353714992333e-07 |
| shell_inner_C | 126.1004 / 126.1004 / 126.1004 | EXACT_OR_ROUNDOFF | — | bekliyor / bekliyor / bekliyor |
