LegendOfOwl/hiz-750-rc-jet/cfd/results/airfoil_SA_M0p6100_A0p0000/coarse_plot.png

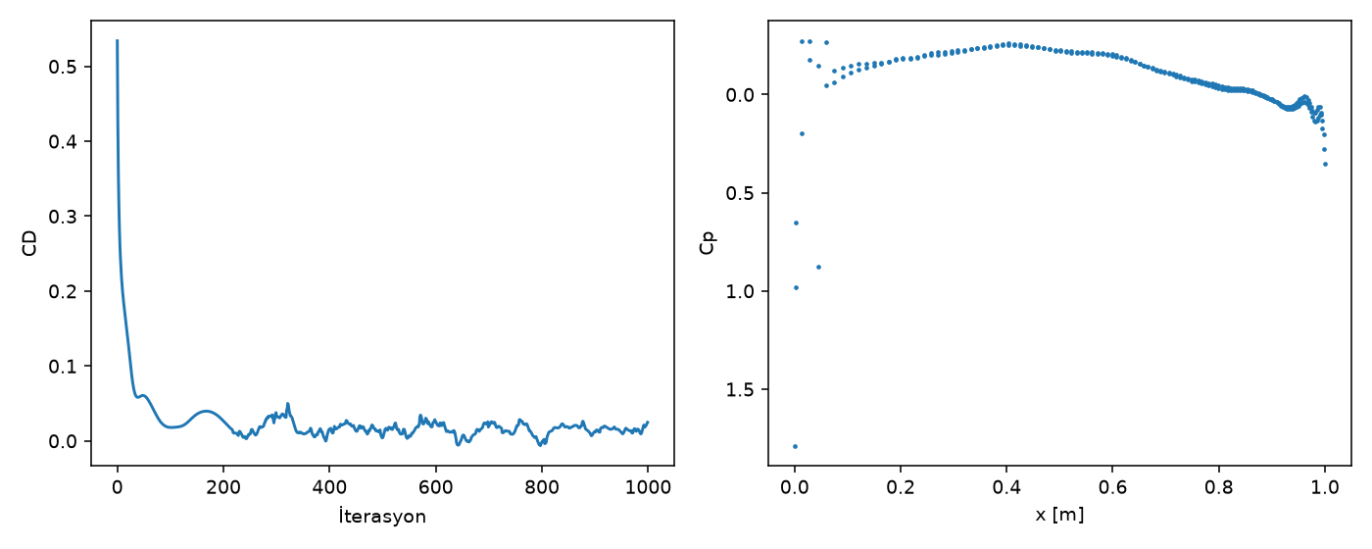
cfd/results/airfoil_SA_M0p6100_A0p0000/coarse_plot.png
