LegendOfOwl/hiz-750-rc-jet/fem/results/stiffening/summary_fine.png

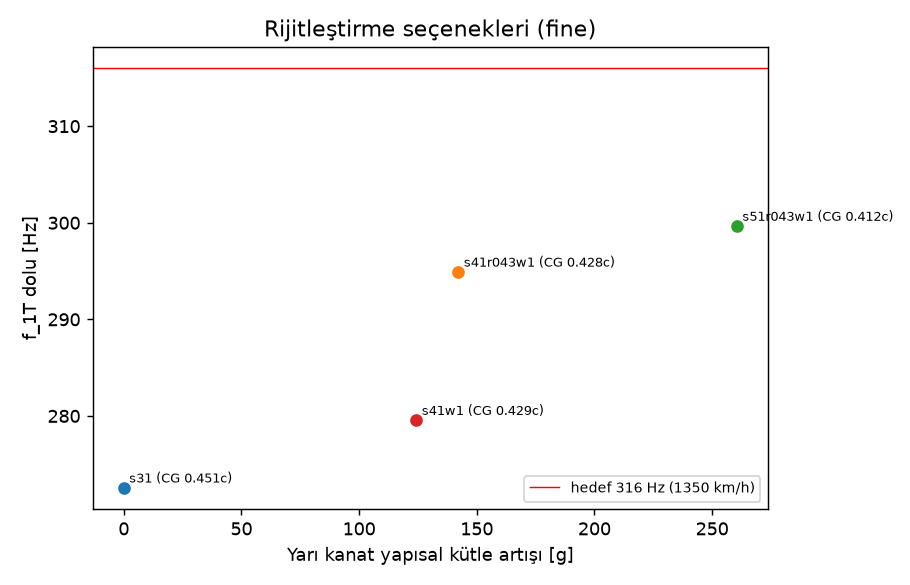
fem/results/stiffening/summary_fine.png
