LegendOfOwl/hiz-750-rc-jet/fem/results/stiffening/summary_fine_corrected.png

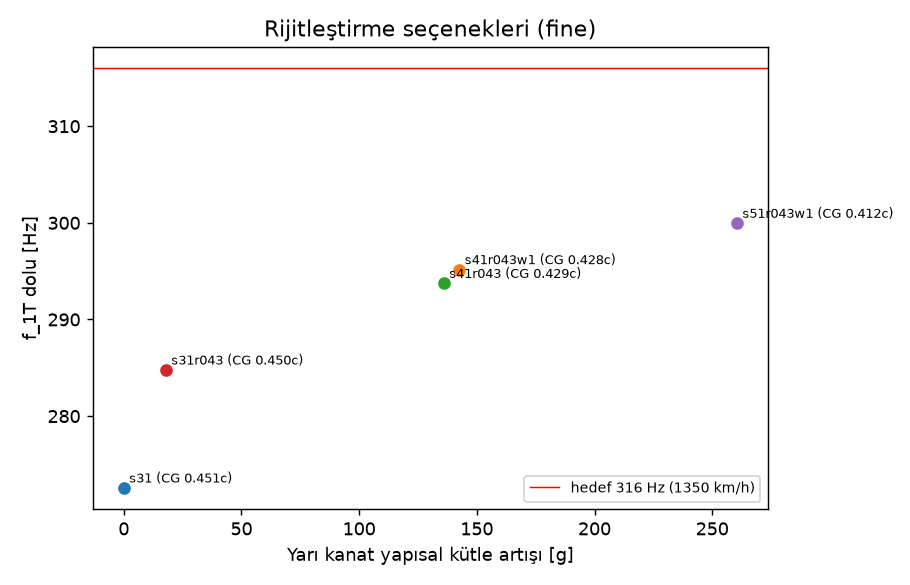
fem/results/stiffening/summary_fine_corrected.png
