LegendOfOwl/hiz-750-rc-jet/fem/results/stiffening/summary_medium.png

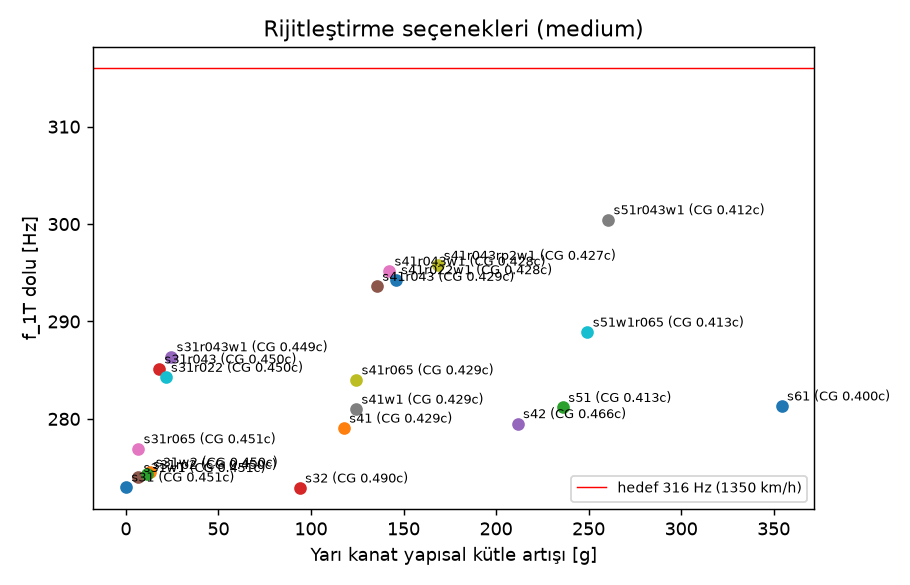
fem/results/stiffening/summary_medium.png
