LegendOfOwl/hiz-750-rc-jet/fem/results/stiffening/wing_empty_s31r043/fine_plot.png

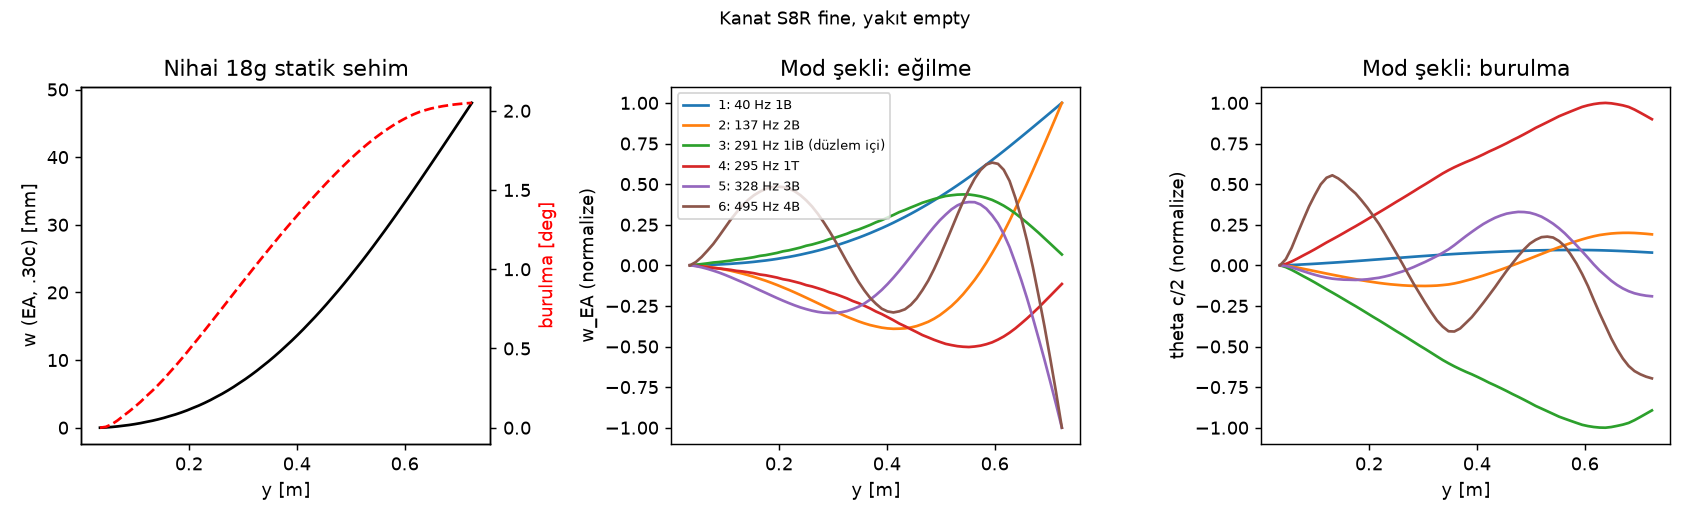
fem/results/stiffening/wing_empty_s31r043/fine_plot.png
