LegendOfOwl/hiz-750-rc-jet/fem/results/stiffening/wing_empty_s41r065/medium_plot.png

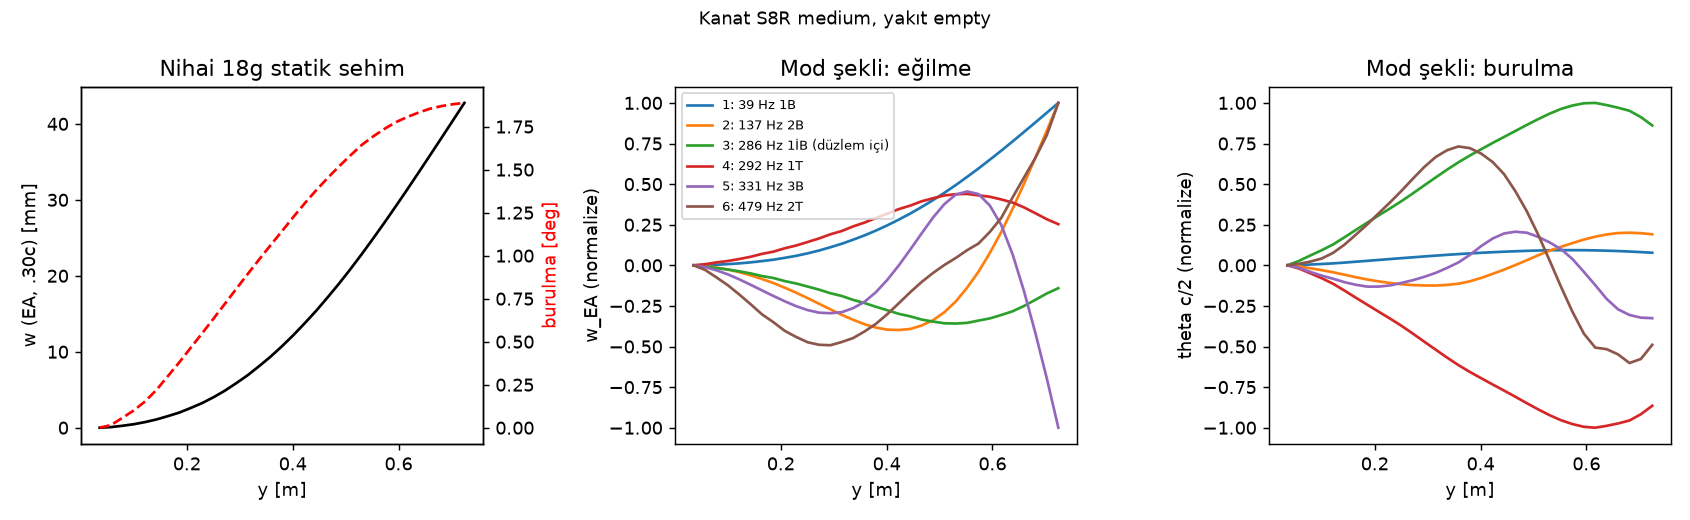
fem/results/stiffening/wing_empty_s41r065/medium_plot.png
