LegendOfOwl/hiz-750-rc-jet/fem/results/stiffening/wing_empty_s51w1r065/medium_plot.png

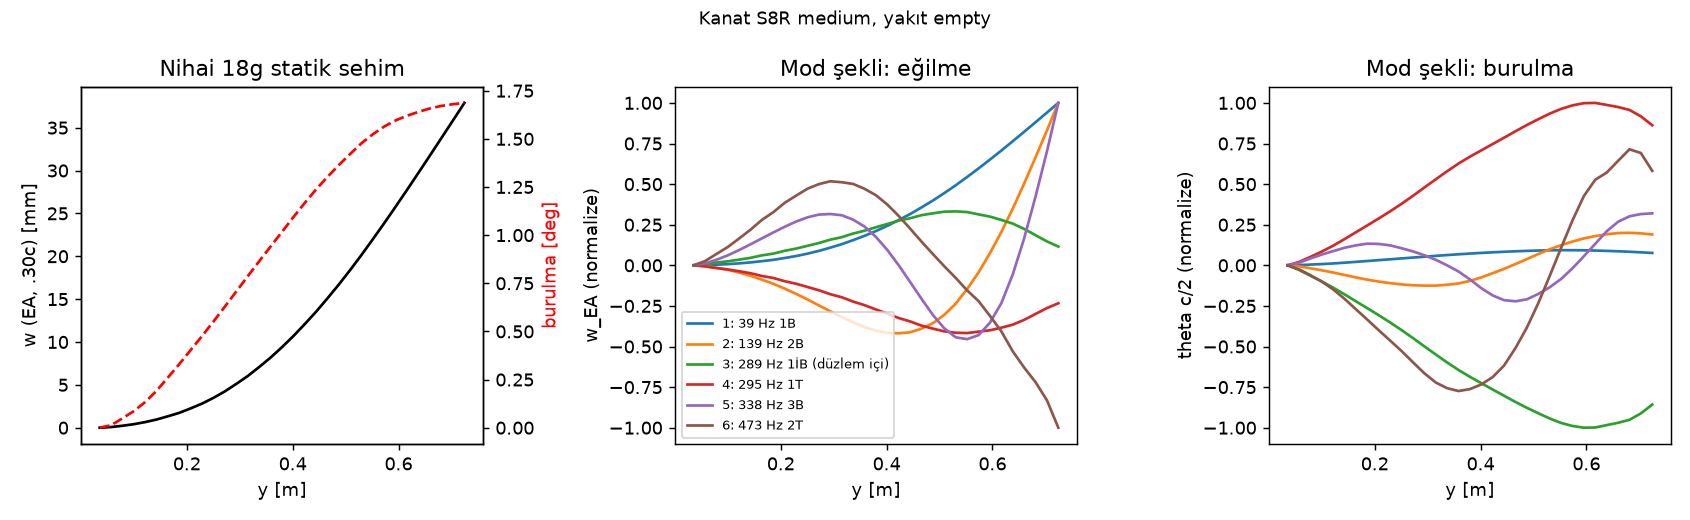
fem/results/stiffening/wing_empty_s51w1r065/medium_plot.png
