LegendOfOwl/hiz-750-rc-jet/fem/results/stiffening/wing_empty_s61/medium_plot.png

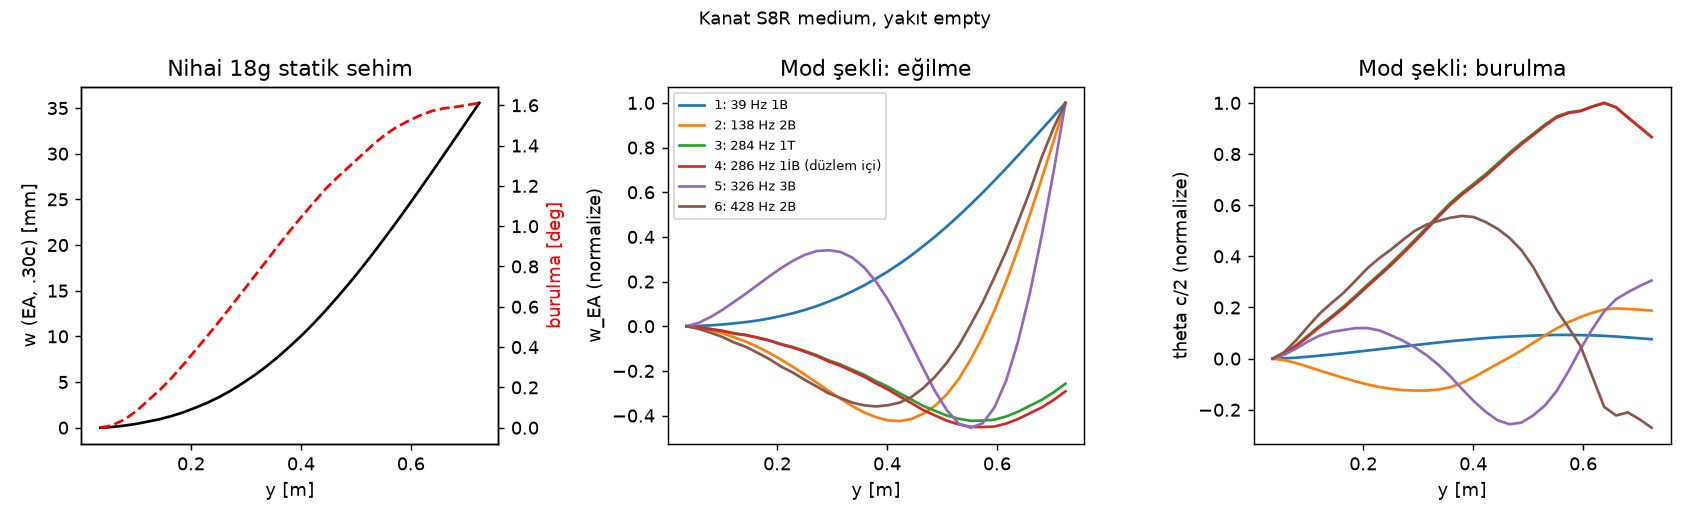
fem/results/stiffening/wing_empty_s61/medium_plot.png
