LegendOfOwl/hiz-750-rc-jet/fem/results/stiffening/wing_s31/medium_plot.png

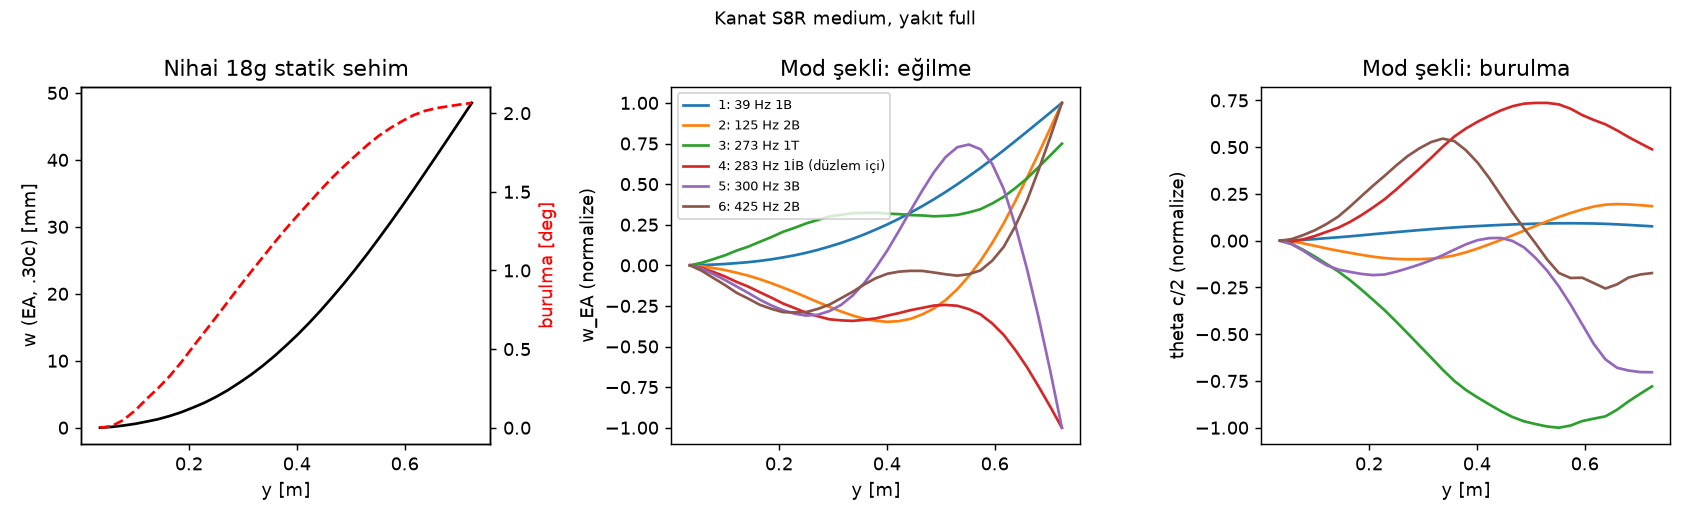
fem/results/stiffening/wing_s31/medium_plot.png
