LegendOfOwl/hiz-750-rc-jet/fem/results/stiffening/wing_s31r043w1/medium_plot.png

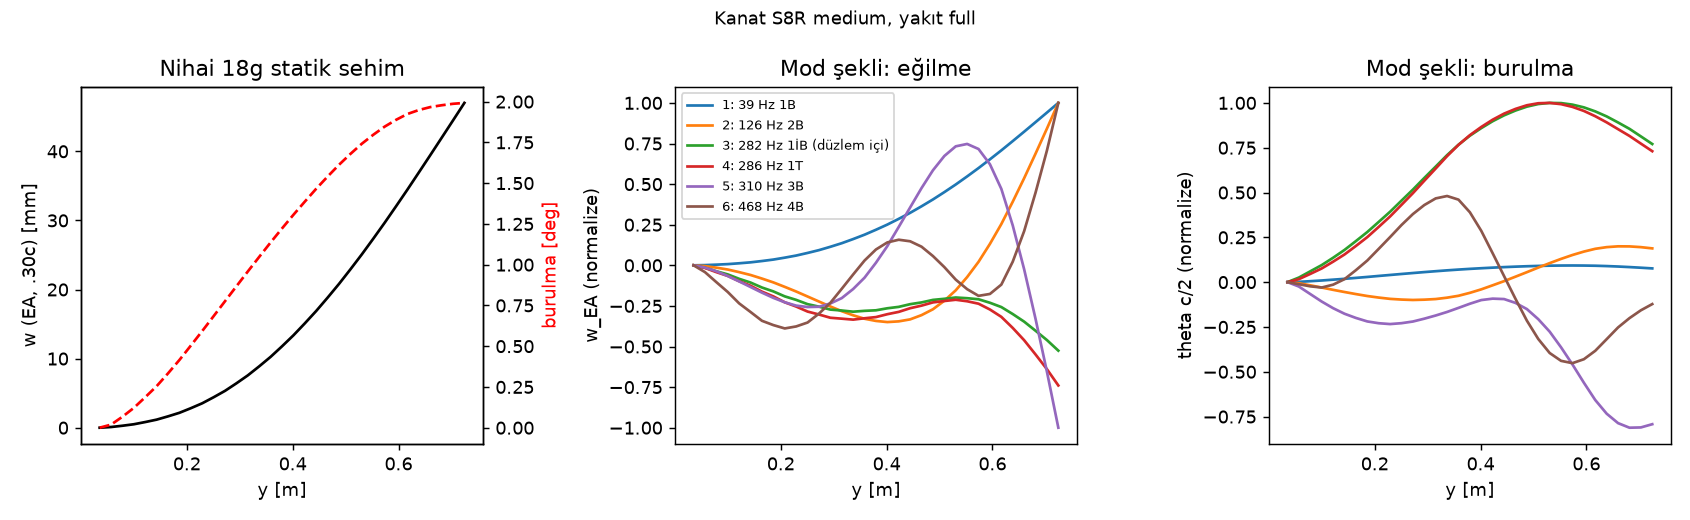
fem/results/stiffening/wing_s31r043w1/medium_plot.png
