LegendOfOwl/hiz-750-rc-jet/fem/results/stiffening/wing_s41r022w1/medium_plot.png

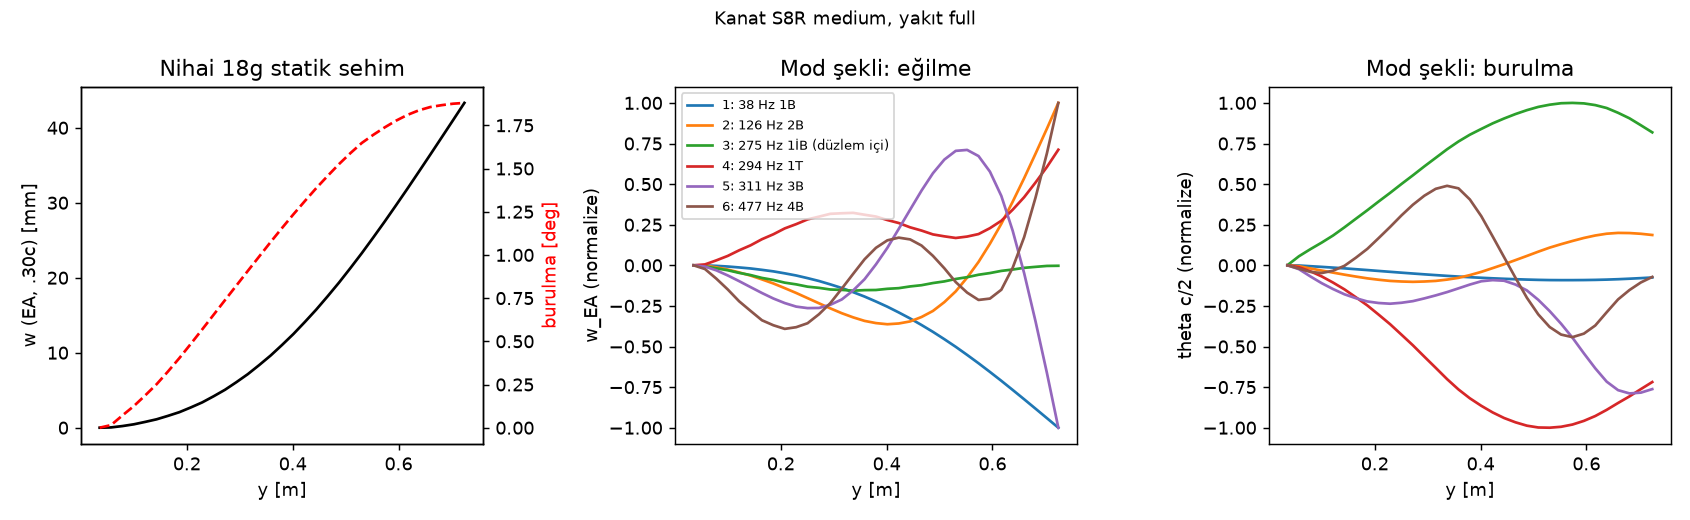
fem/results/stiffening/wing_s41r022w1/medium_plot.png
