LegendOfOwl/hiz-750-rc-jet/fem/results/stiffening/wing_s42/medium_plot.png

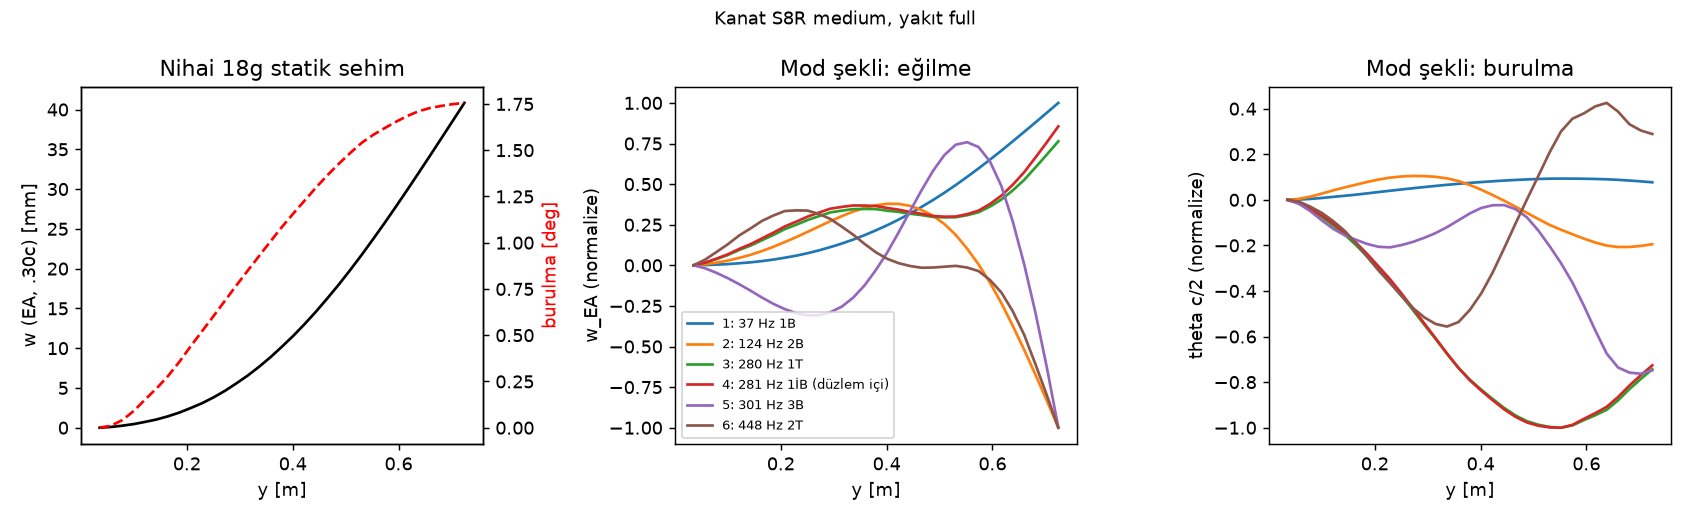
fem/results/stiffening/wing_s42/medium_plot.png
