LegendOfOwl/hiz-750-rc-jet/fem/results/stiffening/wing_s51r043w1/fine_plot.png

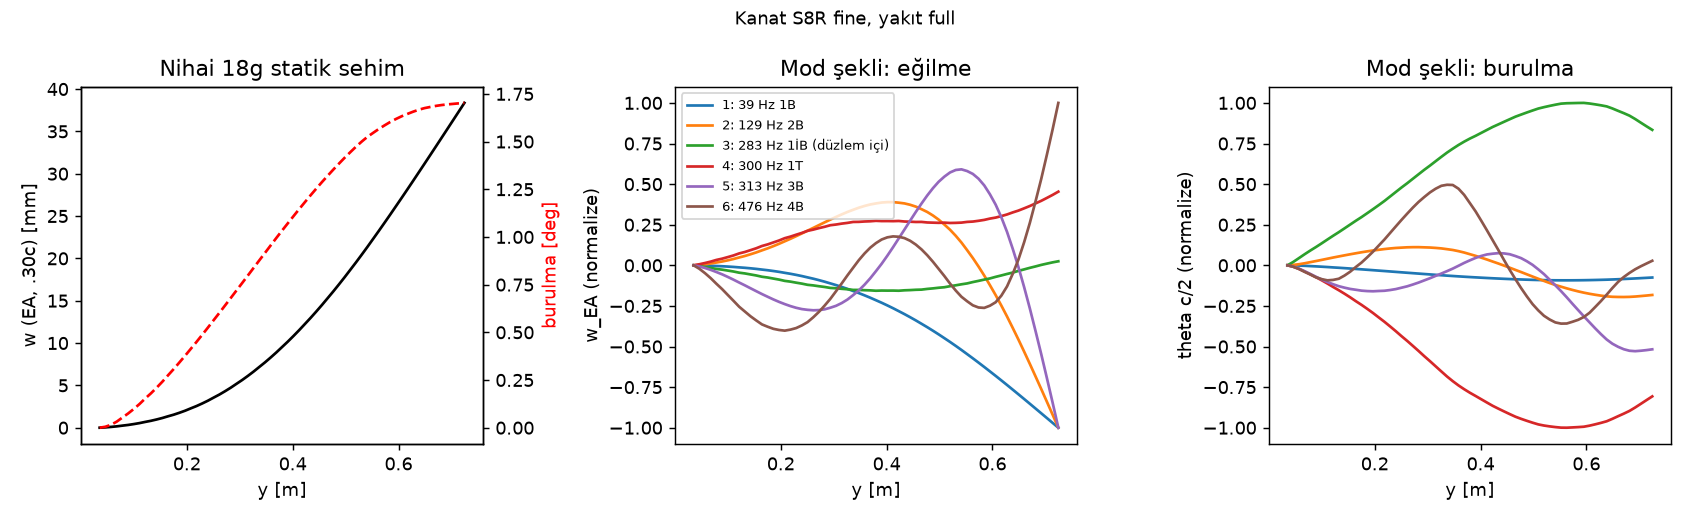
fem/results/stiffening/wing_s51r043w1/fine_plot.png
