LegendOfOwl/hiz-750-rc-jet/fem/results/wing_compare.png

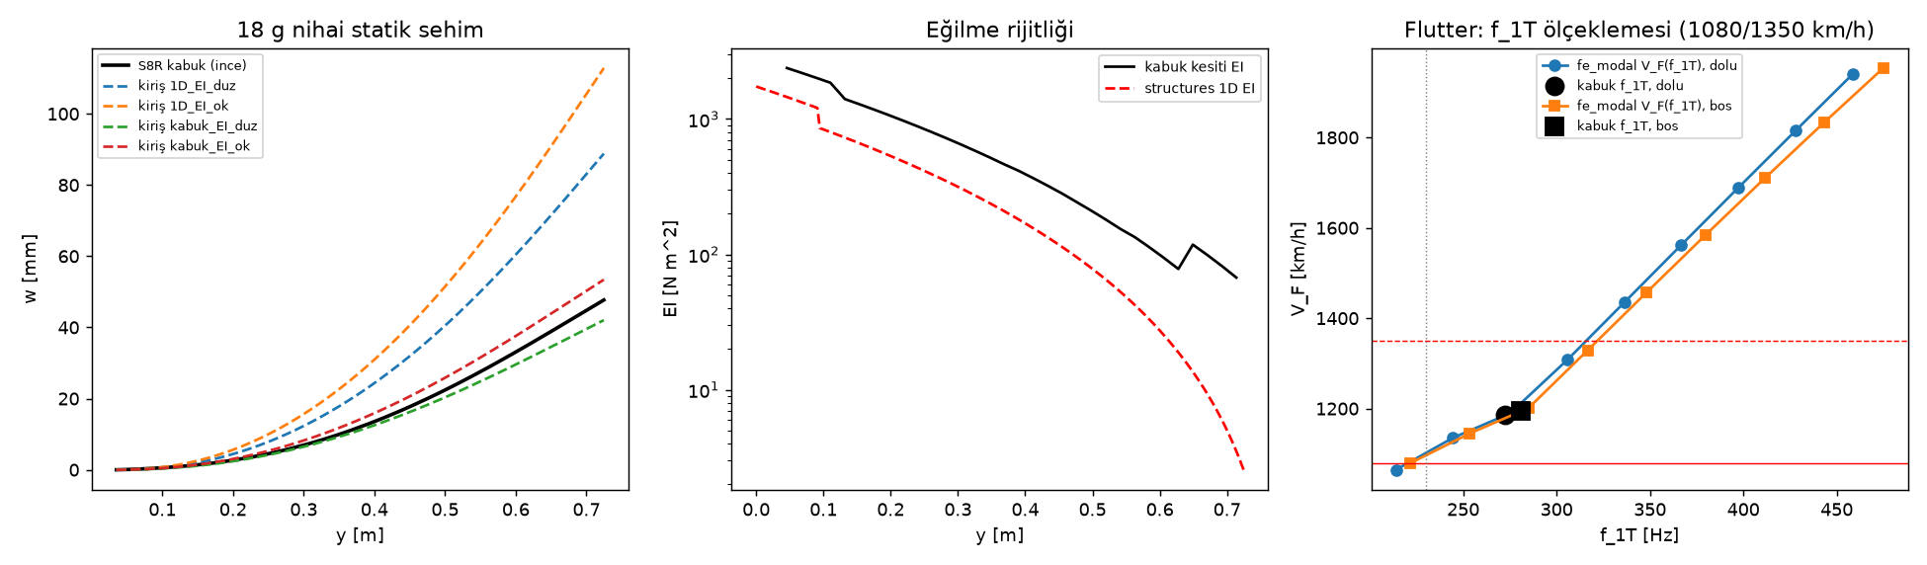
fem/results/wing_compare.png
