LegendOfOwl/hiz-750-rc-jet/fem/results/wing_empty/coarse_plot.png

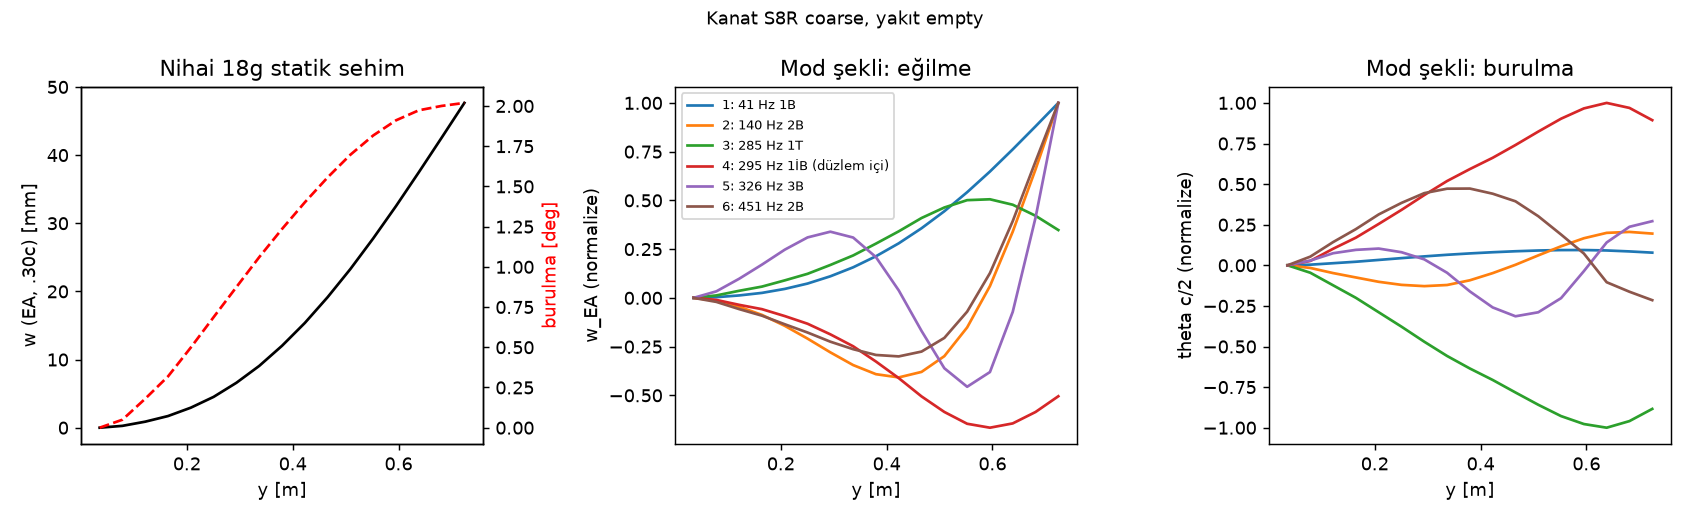
fem/results/wing_empty/coarse_plot.png
