LegendOfOwl/hiz-750-rc-jet/performance/out/cg_zarfi.png

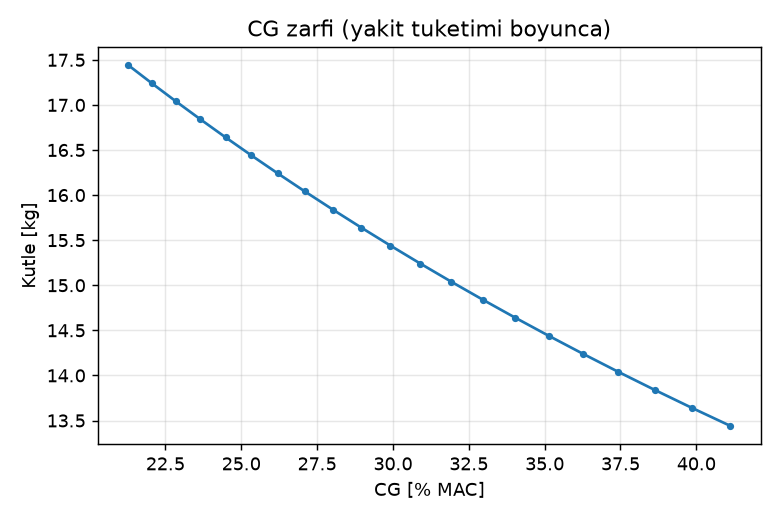
performance/out/cg_zarfi.png
