LegendOfOwl/hiz-750-rc-jet/thermal/results/engine_thermal_T250_F0_1ed7ca8299/coarse_plot.png

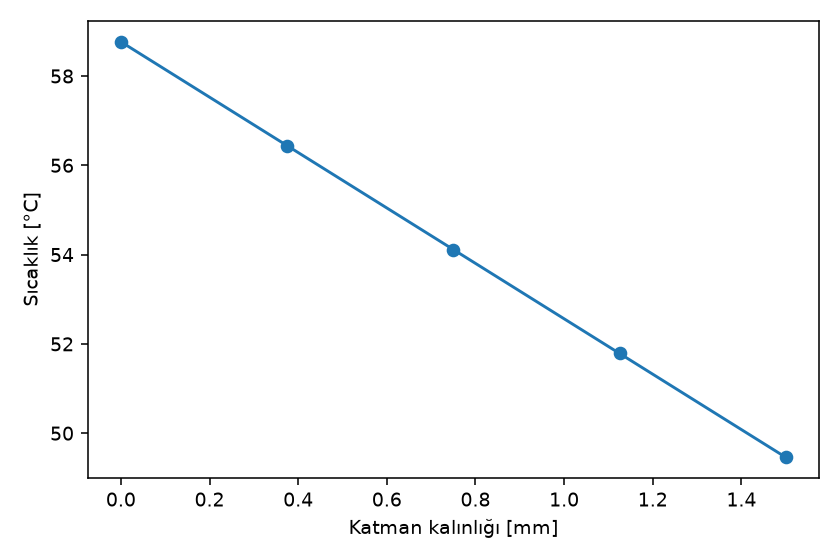
thermal/results/engine_thermal_T250_F0_1ed7ca8299/coarse_plot.png
