LegendOfOwl/hiz-750-rc-jet/thermal/results/engine_thermal_T250_F0_679b6a3875/coarse_plot.png

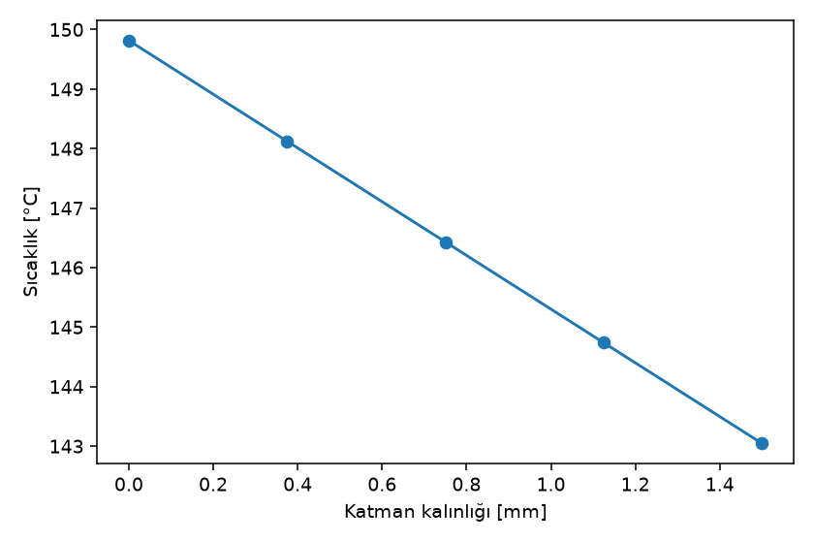
thermal/results/engine_thermal_T250_F0_679b6a3875/coarse_plot.png
