LegendOfOwl/hiz-750-rc-jet/validation/results/cantilever/coarse_plot.png

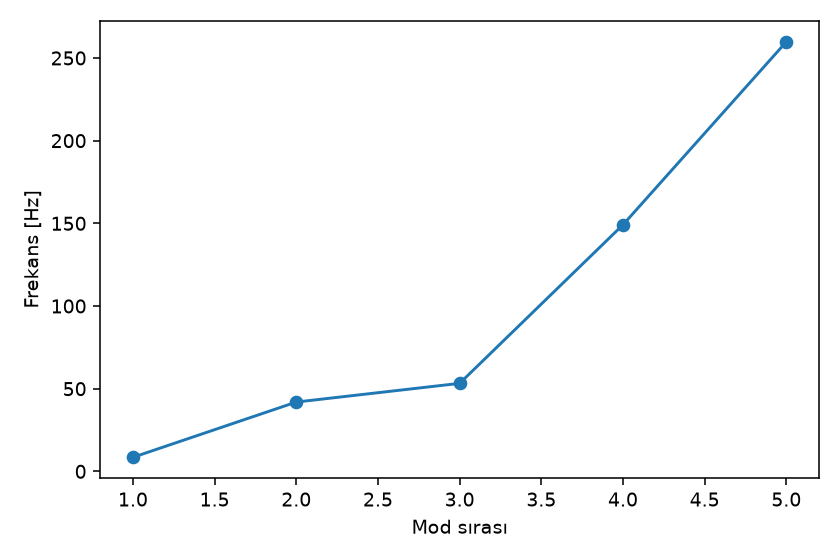
validation/results/cantilever/coarse_plot.png
