LegendOfOwl/hiz-750-rc-jet/validation/results/coupon/coarse_plot.png

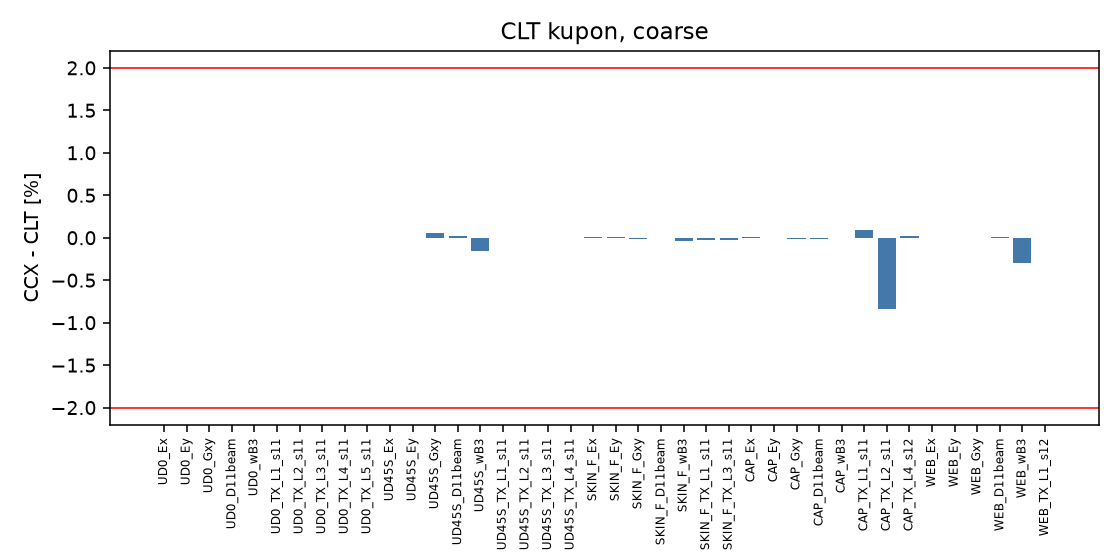
validation/results/coupon/coarse_plot.png
