LegendOfOwl/hiz-750-rc-jet/validation/results/flat_plate_SA/coarse_plot.png

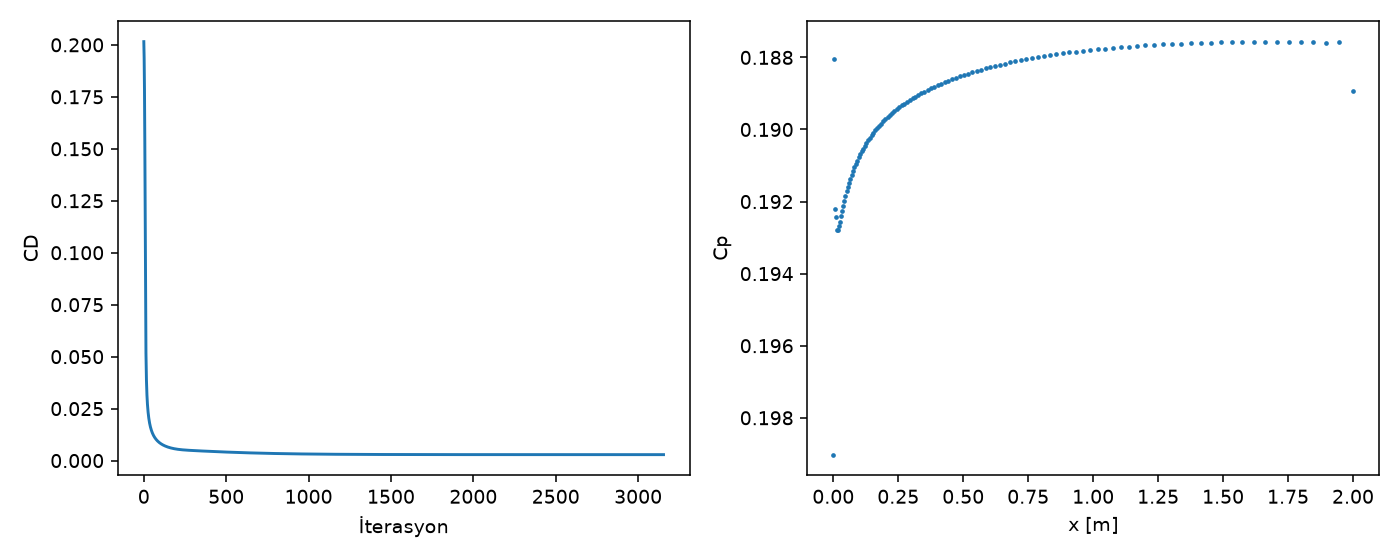
validation/results/flat_plate_SA/coarse_plot.png
