LegendOfOwl/hiz-750-rc-jet/validation/results/flat_plate_SA/fine_plot.png

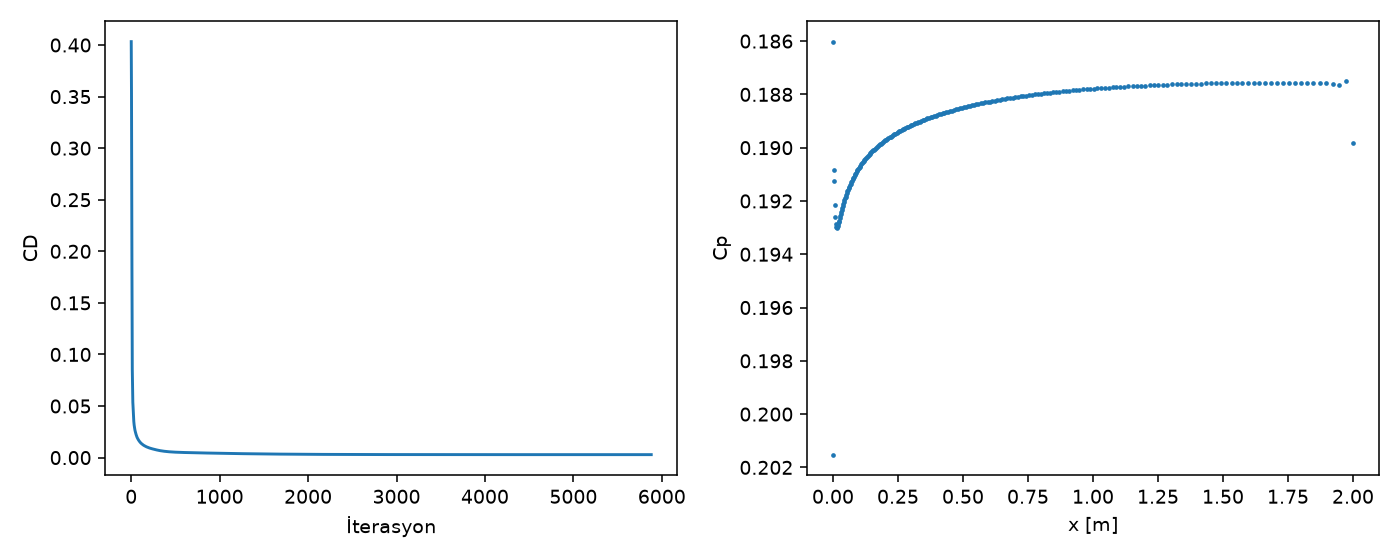
validation/results/flat_plate_SA/fine_plot.png
