LegendOfOwl/hiz-750-rc-jet/validation/results/rae2822_SA/coarse_plot.png

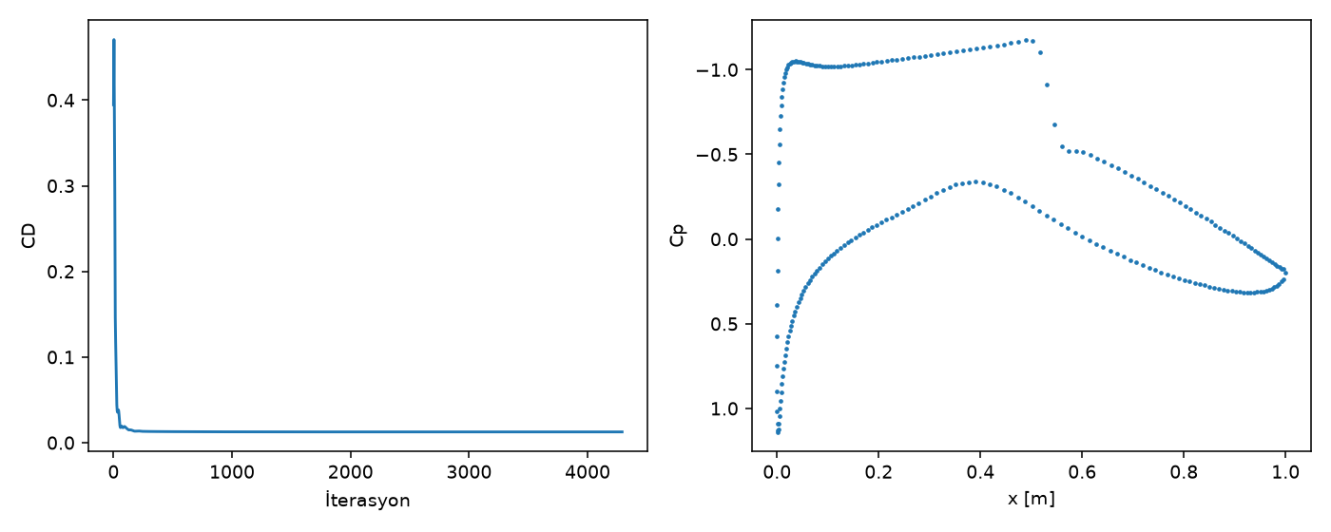
validation/results/rae2822_SA/coarse_plot.png
