LegendOfOwl/hiz-750-rc-jet/validation/results/thermal_1d/coarse_plot.png

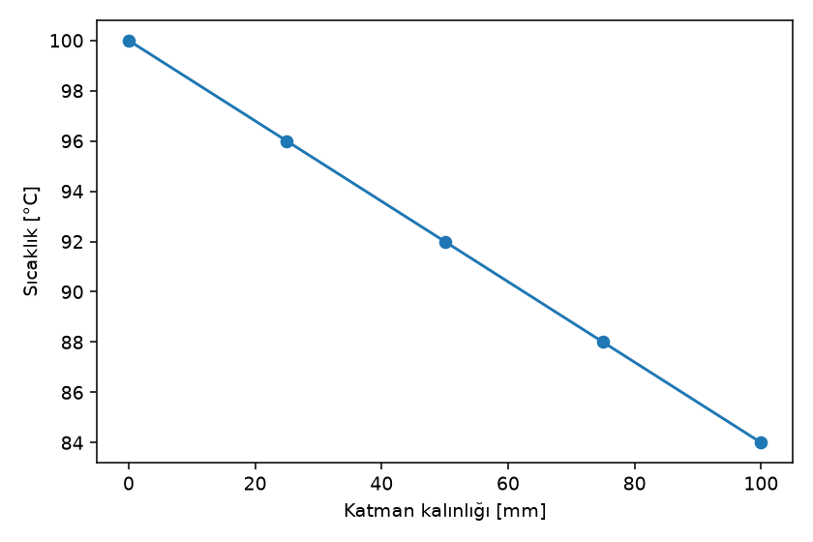
validation/results/thermal_1d/coarse_plot.png
