LegendOfOwl/hiz-750-rc-jet/cad/out/HIZ750_3view.pdf

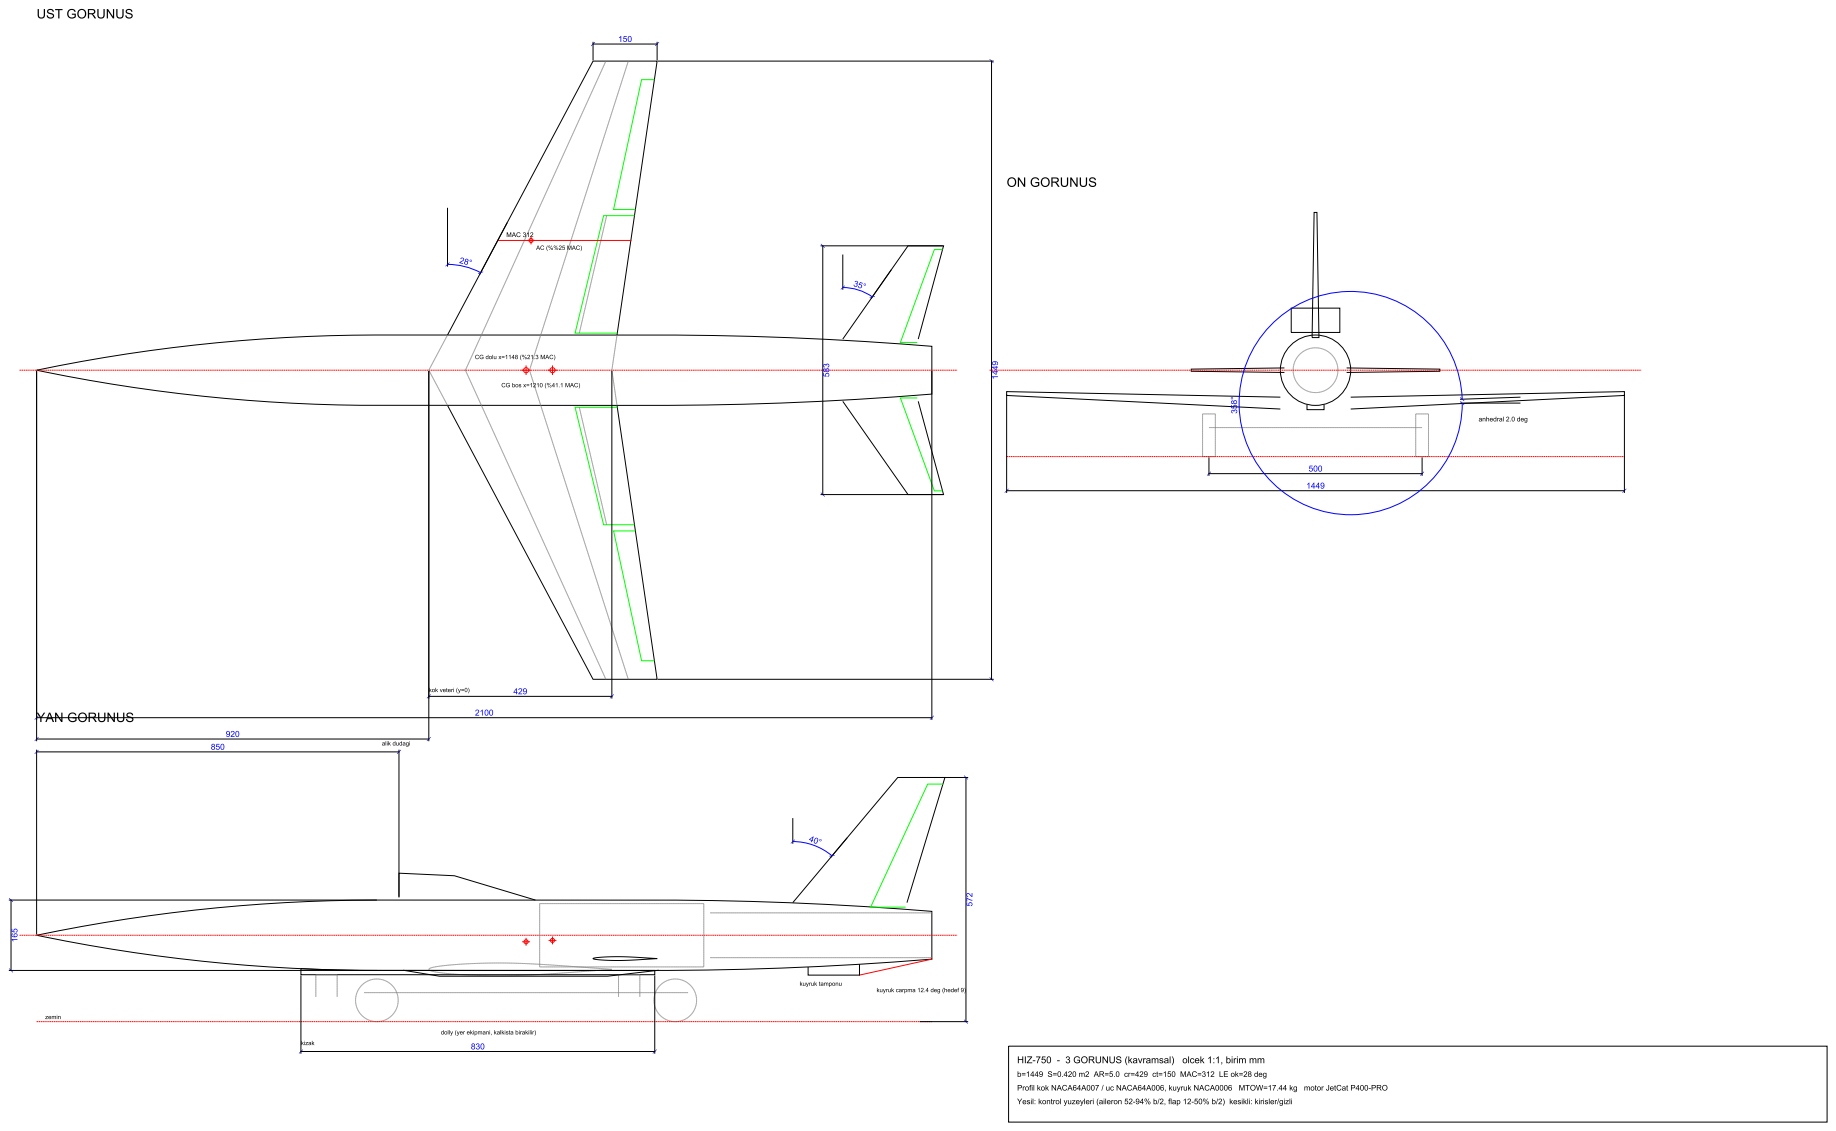
[picture p114: page 1]
