LegendOfOwl/hiz-750-rc-jet/validation/results/flat_plate_SA/coarse_case.cfg

SOLVER= RANS
KIND_TURB_MODEL= SA
MATH_PROBLEM= DIRECT
RESTART_SOL= NO
MACH_NUMBER= 0.2
AOA= 0.0
REYNOLDS_NUMBER= 5000000.0
REYNOLDS_LENGTH= 1.0
FREESTREAM_TEMPERATURE= 300.0
FREESTREAM_TURBULENCEINTENSITY= 0.001
FREESTREAM_TURB2LAMVISCRATIO= 100.0
REF_AREA= 2.0
REF_LENGTH= 1.0
REF_ORIGIN_MOMENT_X= 0
REF_ORIGIN_MOMENT_Y= 0
REF_ORIGIN_MOMENT_Z= 0
MARKER_HEATFLUX= ( WALL, 0.0 )
MARKER_MONITORING= ( WALL )
MARKER_PLOTTING= ( WALL )
NUM_METHOD_GRAD= GREEN_GAUSS
CONV_NUM_METHOD_FLOW= ROE
MUSCL_FLOW= YES
SLOPE_LIMITER_FLOW= NONE
CONV_NUM_METHOD_TURB= SCALAR_UPWIND
MUSCL_TURB= NO
TIME_DISCRE_FLOW= EULER_IMPLICIT
TIME_DISCRE_TURB= EULER_IMPLICIT
CFL_NUMBER= 1.0
CFL_ADAPT= YES
CFL_ADAPT_PARAM= ( 0.5, 1.5, 1.0, 100.0 )
MGLEVEL= 0
LINEAR_SOLVER= FGMRES
LINEAR_SOLVER_PREC= ILU
LINEAR_SOLVER_ITER= 10
LINEAR_SOLVER_ERROR= 1E-6
ITER= 30000
CONV_FIELD= ( RMS_NU_TILDE, DRAG )
CONV_CAUCHY_ELEMS= 100
CONV_CAUCHY_EPS= 1e-8
CONV_RESIDUAL_MINVAL= -9.3
CONV_STARTITER= 100
MESH_FILENAME= mesh.su2
MESH_FORMAT= SU2
TABULAR_FORMAT= CSV
CONV_FILENAME= history
SURFACE_FILENAME= surface_flow
VOLUME_FILENAME= flow
OUTPUT_FILES= ( RESTART, SURFACE_CSV, PARAVIEW )
OUTPUT_WRT_FREQ= 1000
WRT_RESTART_COMPACT= NO
HISTORY_OUTPUT= ( ITER, RMS_RES, AERO_COEFF )
VOLUME_OUTPUT= ( COORDINATES, SOLUTION, PRIMITIVE )
OUTPUT_PRECISION= 12
MARKER_SYM= ( SYMMETRY )
MARKER_INLET= ( INLET, 302.4, 118309.784, 1.0, 0.0, 0.0 )
MARKER_OUTLET= ( OUTLET, 115056.0, FARFIELD, 115056.0 )
MGCYCLE= V_CYCLE
MG_PRE_SMOOTH= (1,2,3,3)
MG_POST_SMOOTH= (2,2,2,2)
MG_CORRECTION_SMOOTH= (0,0,0,0)
MG_DAMP_RESTRICTION= 0.8
MG_DAMP_PROLONGATION= 0.8
