LegendOfOwl/hiz-750-rc-jet/(commit log)

2026-11-04 Kavramsal boyutlandirma: itki/surukleme, Vmax, motor trade study (v0.1)
2026-11-04 Parametrik CAD (CadQuery): 27 parca STEP/STL, montaj, DXF/PDF cizimler
    [HIZ750_3view.dxf, HIZ750_assembly.step, HIZ750_on_dolly.step, aileron_L.step, aileron_L.stl, aileron_R.step, aileron_R.stl, belly_fairing.step]
2026-11-04 Temizlik: iter2'den kalan karin tanki ciktilari silindi, .claude/ yok sayildi
    [tank_belly.step, tank_belly.stl]
2026-11-04 Kutle/atalet: CAD katilarindan kutle, CG ve atalet tensoru; params kabuk konumu ve burun balasti duzeltmesi
2026-11-04 Ucus kontrol yasasi: n_z/g-limiter, yaw damper, roll; paylar, simulasyonlar, kazanc tablosu
    [fc_kazanc_tablosu.csv]
2026-11-04 CAD ciktilari iter4 parametreleriyle yeniden uretildi
    [HIZ750_3view.dxf, HIZ750_assembly.step, HIZ750_on_dolly.step, aileron_L.step, aileron_R.step, belly_fairing.step, dolly.step, dolly.stl]
2026-11-04 PR #1 inceleme duzeltmeleri: kullanilabilir tank hacmi, yakit CG, alik modeli, run_all.sh; ciktilar yeniden uretildi
    [HIZ750_3view.dxf, HIZ750_assembly.step, HIZ750_on_dolly.step, aileron_L.step, aileron_R.step, belly_fairing.step, dolly.step, dolly.stl]
2026-11-04 v0.6 taslak: yuksek dogruluk dogrulama paketi (SU2/CalculiX/gmsh); konsol ve 1B termal benchmark kabul, motor bolmesi termal, CFD acik
    [coarse_case.cfg, machine_probe.json]
2026-11-04 Termal bulgu: 2 mm isi kecesi zorunlu, yer calistirma termokupl kriteri (FMEA, test plani, params)
2026-11-04 FEM iter5: CLT kupon benchmark kabul, kompozit kanat kabuk statik/modal/Tsai-Wu (REVIEW_REQUIRED); f_1T 272.5 Hz -> flutter ~1185 km/h
2026-11-04 Iter5 kanat rijitlestirme: kabuk 4/1 kat, 43 mm kaburga, web +1 kat (f_1T 272.5 -> 294.9 Hz, Vf ~1266 km/h, +0.28 kg); 21 secenekli FEM calismasi; zincir yeniden uretildi (MTOW 17.44 kg)
    [HIZ750_3view.dxf, HIZ750_assembly.step, HIZ750_on_dolly.step, aileron_L.step, aileron_R.step, belly_fairing.step, dolly.step, dolly.stl]
2026-11-05 Dokumanlar: iter5 FEM, kanat rijitlestirme, yeni flutter tasarim degeri (~1266 km/h), MTOW 17.44 kg; basarim agaci kayip worktree notu
2026-11-05 FEM inceleme duzeltmeleri: sandvic cakisma ve kaburga-web uyumu zorunlu kapi, cift kutle, sabit iter4 flutter referansi, acik varyantlar, structures main 4/1, CCX tek thread, kupon onkosul; s41r043w1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
    [HIZ750_3view.dxf, HIZ750_assembly.step, HIZ750_on_dolly.step, aileron_L.step, aileron_R.step, belly_fairing.step, dolly.step, elevator_L.step]
2026-11-05 CFD iter5 v2: duz levha SA BENCHMARK_ACCEPTED (ince GCI %0.88); RAE tek blok C-agi (100c, min kose sinusu .707), NASA referansi yeniden indirildi; RAE kaba MG0 PENDING (iz bolgesi); inceleme paketi o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
    [coarse_case.cfg, fine_case.cfg, medium_case.cfg]
2026-11-05 Iter5 kapanis: GCI tek-sifir-fark duzeltmesi (PLATEAU_UNRESOLVED), 3B CFD CMy, artefakt baseline v0.5.0'a baglandi; README/CHANGELOG/docs10/basarim agaci son sayilar (31 test, check_artifacts PASS)
2026-11-08 Grup1 zincir/dokuman incelemesi: sizing params'a baglandi (MTOW 17.44), tirmanma ve dolly duzeltmesi, pitot dq ayrimi, docs/09 iter5 kutlesiyle; Codex disiplinlerarasi inceleme raporu
    [HIZ750_3view.dxf, HIZ750_assembly.step, HIZ750_on_dolly.step, aileron_L.step, aileron_R.step, belly_fairing.step, dolly.step, elevator_L.step]
2026-11-08 Grup1 CFD/dogrulama incelemesi: RAE iz kesiti agi duzeltildi (kaba ag kapiyi gecti), dusuk p icin GCI Fs=3 (%1.82), STALE kapsami daraltildi ve thermal_1d/konsol/kupon yeniden kabul; shell_flutter JS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
    [coarse_case.cfg, fine_case.cfg, medium_case.cfg, v2_mg0_coarse_unconverged_case.cfg]
2026-11-08 Grup2 karar ekibi (Codex Astra/Sol + Claude Sonnet, 2 tur capraz dogrulama): iter5 tutulur, flutter calisma degeri 1267, servo once FEM, tank yeterliligi kanitlanmadi, ucus oncesi engeller; entegrasy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
